alanbagish/C40_upgrades/C40 IMB Upgrade.docx

C40 IMB Upgrade

02/21/2013

1. X-axis guider 1
  a. TMG 5609L-0502 400 steps/rev NEMA 23 stepper 1 each (4 on order)
  b. US Digital E2 relative Encoder E2-400-250-IE-D-D-8 1 each (5 each on hand)
  c. Pepperl+Fuchs NBN4-F29-AO Inductive Proximity NPN N.C. 2 each (1 each on hand, 9 each on order)

Y-axis guider 1

a. TMG 5609L-0502 400 steps/rev NEMA 23 stepper 1 each
b. US Digital E2 relative Encoder E2-400-250-IE-D-D-8 1 each
c. Pepperl+Fuchs NBN4-F29-AO Inductive Proximity N.C. 2 each

Focus 1

  a. Haydon/Kerk Hybrid Linear Actuator Size NEMA 23 Part #: 57J47-05-003ENG 1 each (3 each on hand).
  b. Pepperl+Fuchs NBN4-F29-AO Inductive Proximity NPN N.C. 2 each
  c. Air Cylinder, MRS-021.5-DXP Bimba 1 each
  d. Air Cylinder, MRS-022.5-DXP Bimba 1 each
  e. Air Cylinder, 0071 Bimba 1 each
  f. Position Sensors: Bimba MSKX 5 each
  g. S-H lenslet control
  h. LED control
2. X-axis guider 2
  a. TMG 5609L-0502 400 steps/rev NEMA 23 stepper 1 each
  b. US Digital E2 relative Encoder E2-400-250-IE-D-D-8 1 each
  c. Pepperl+Fuchs NBN4-F29-AO Inductive Proximity NPN N.C. 2 each

Y-axis guider 2

a. TMG 5609L-0502 400 steps/rev NEMA 23 stepper 1 each
b. US Digital E2 relative Encoder E2-400-250-IE-D-D-8 1 each
c. Pepperl+Fuchs NBN4-F29-AO Inductive Proximity NPN N.C. 2 each

Focus 2

a. Haydon/Kerk Hybrid Linear Actuator Size NEMA 23 Part #: 57J47-05-003ENG 1 each
b. Pepperl+Fuchs NBN4-F29-AO Inductive Proximity NPN N.C. 2 each
c. Air Cylinder, MRS-021.5-DXP Bimba 1 each
d. Air Cylinder, MRS-022.5-DXP Bimba 1 each
e. Air Cylinder, 0071 Bimba 1 each
f. Position Sensors: Bimba MSKX 5 each
g. S-H lenslet control
h. LED control
3. Filter Wheel 1

6 position

Detent A microswitch Honeywell 311SM4-T 1 each

Detent B microswitch Honeywell 311SM4-T 1 each

TMG 5609L-0502 0.9 Degree, 400 Steps/Rev Hybrid Stepper, NEMA 23 1 each

Encoder: BEI-HS35F absolute hollow core 4096 or 8192 counts/rev 1 each

4. Filter Wheel 2

6 position

Detent A microswitch Honeywell 311SM4-T 1 each

Detent B microswitch Honeywell 311SM4-T 1 each

TMG 5609L-0502 0.9 Degree, 400 Steps/Rev Hybrid Stepper, NEMA 23 1 each

Encoder: BEI-HS35F absolute hollow core 4096 or 8192 counts/rev. 1 each

5. Galil DMC-4080(ISCNTL)-C012(P422)-I200(SSI,STEP)-I200(SSI,STEP)-D4040-D4040 1 each (on hand)
