alanbagish/C40_upgrades/C40_Tyson_docs/SwopeCommandCommunications.pdf

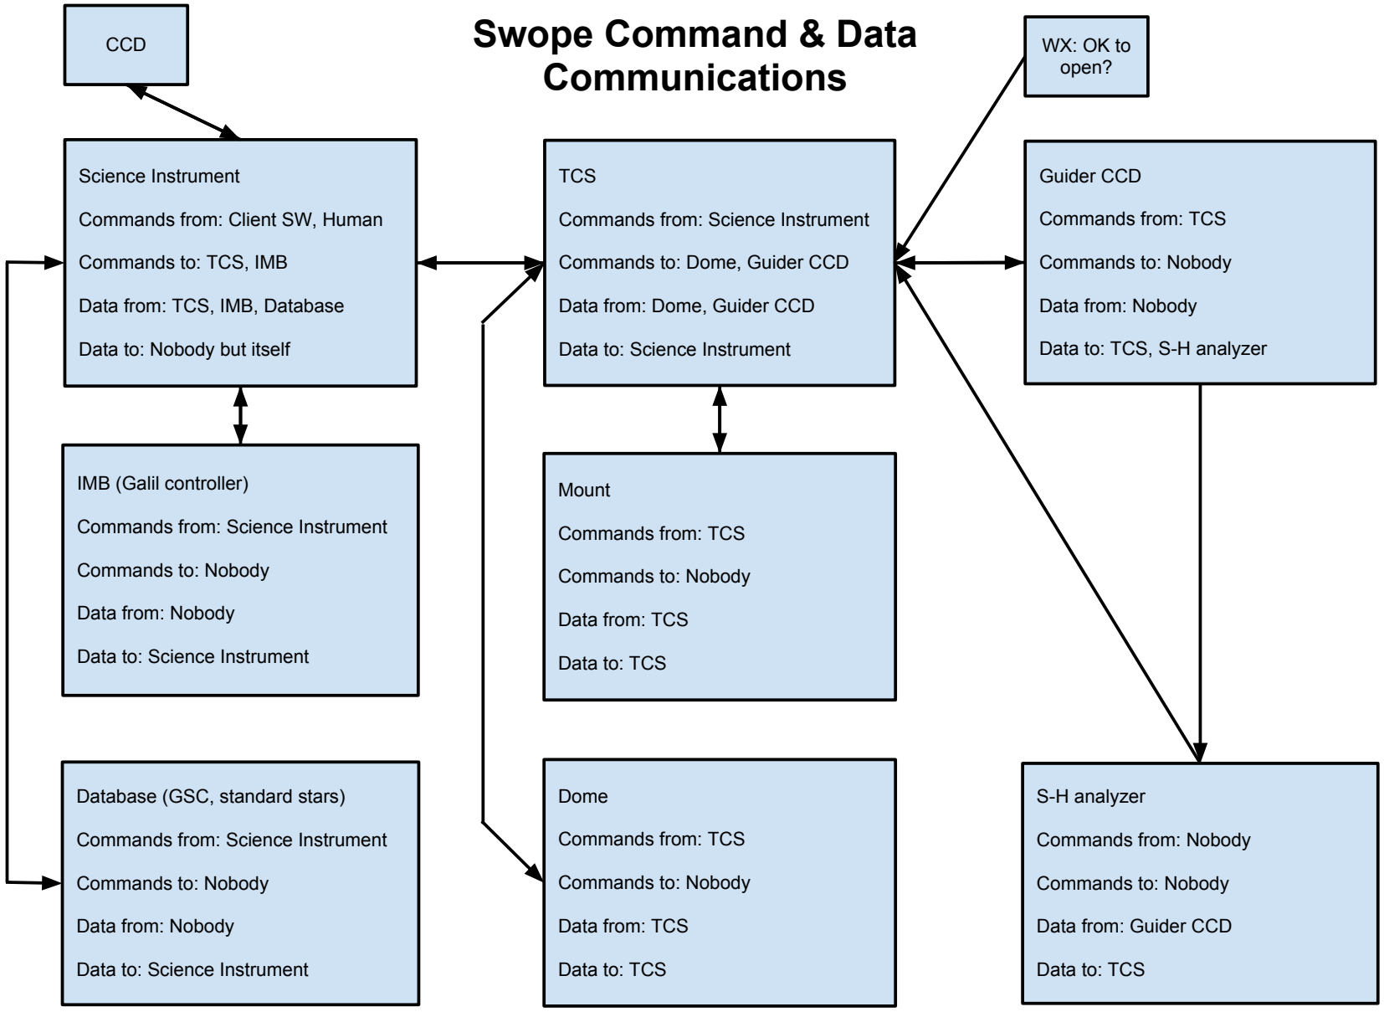
[picture p1: figure]
TCS; Commands from: Science Instrument; Commands to: Dome, Guider CCD; Data from: Dome, Guider CCD; Data to: Science Instrument; IMB (Galil controller); Commands to: Nobody; Data from: Nobody; Guider CCD; Commands from: TCS; Data to: TCS, S-H analyzer; Science Instrument; Commands from: Client SW, Human; Commands to: TCS, IMB; Data from: TCS, IMB, Database; Data to: Nobody but itself; Dome; Data from: TCS; Data to: TCS; S-H analyzer; Commands from: Nobody; Data from: Guider CCD; Swope Command & Data Communications; Database (GSC, standard stars); Mount; WX: OK to open?; CCD
