alanbagish/C40_upgrades/Documents/connectors/3D_CVM_CVM_1735447-8_F.pdf

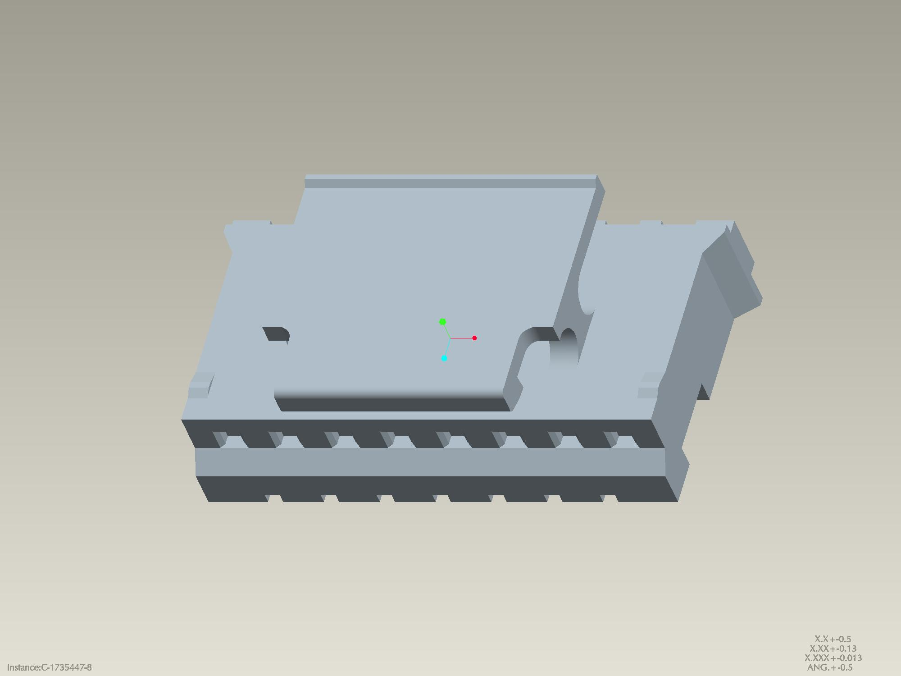
[picture p2: page 1]
