alanbagish/C40_upgrades/Documents/connectors/Molex - 050579404_sd.pdf

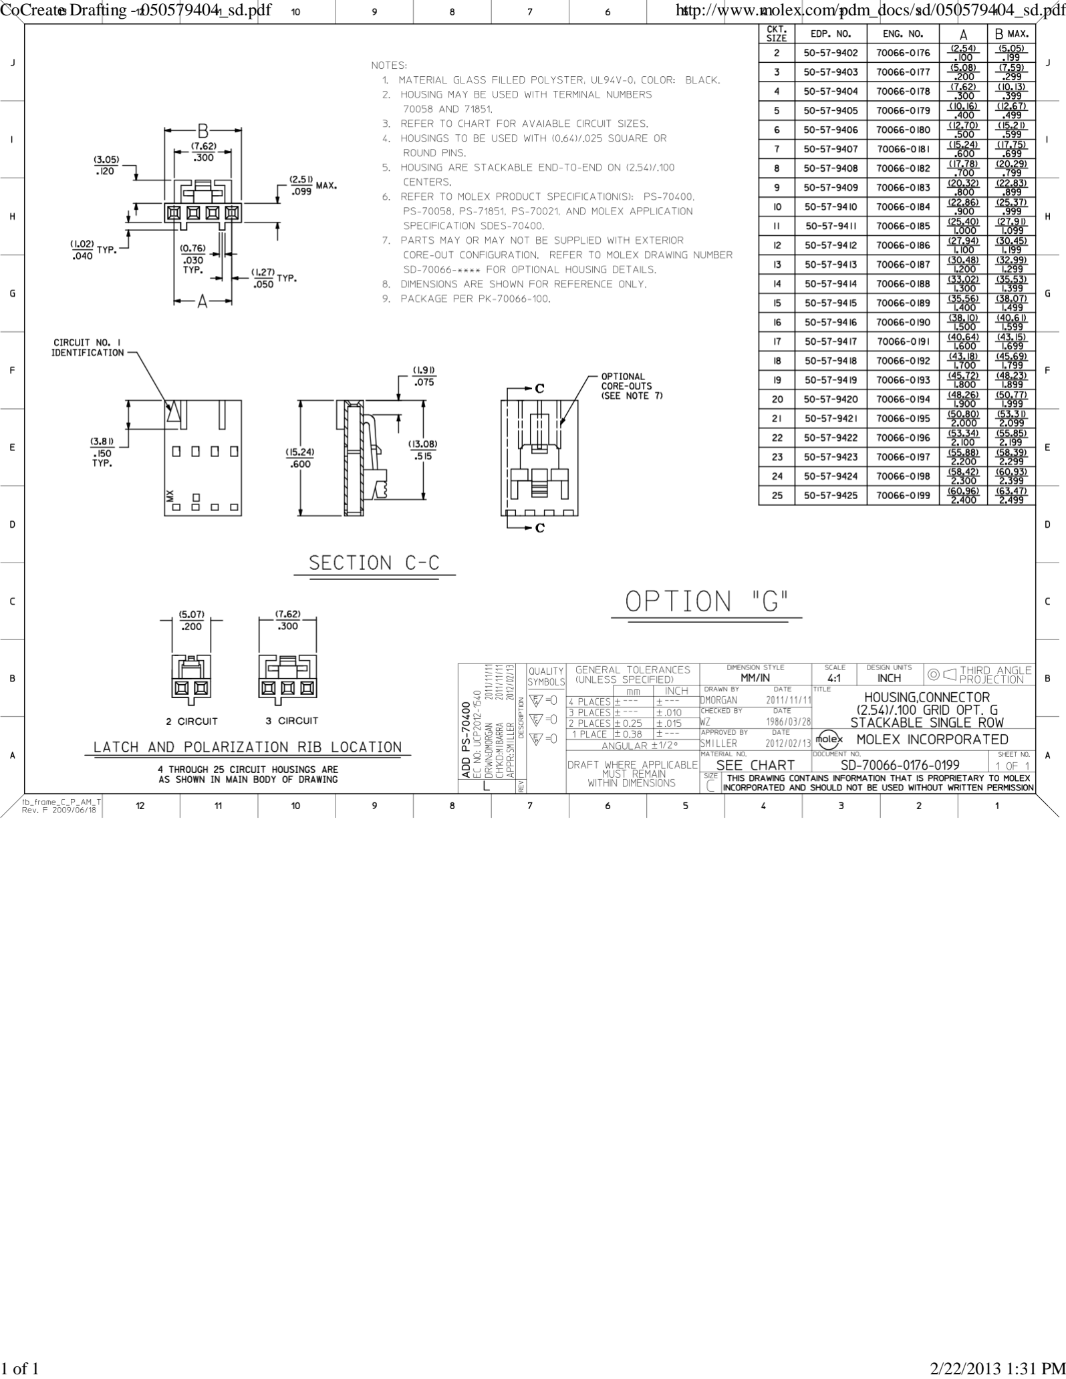
[picture p3: page 1]

CoCreate Drafting - 050579404_sd.pdf | http://www.molex.com/pdm_docs/sd/050579404_sd.pdf
1 of 1 | 2/22/2013 1:31 PM
