alanbagish/C40_upgrades/Documents/connectors/Molex 022552082_sd.pdf

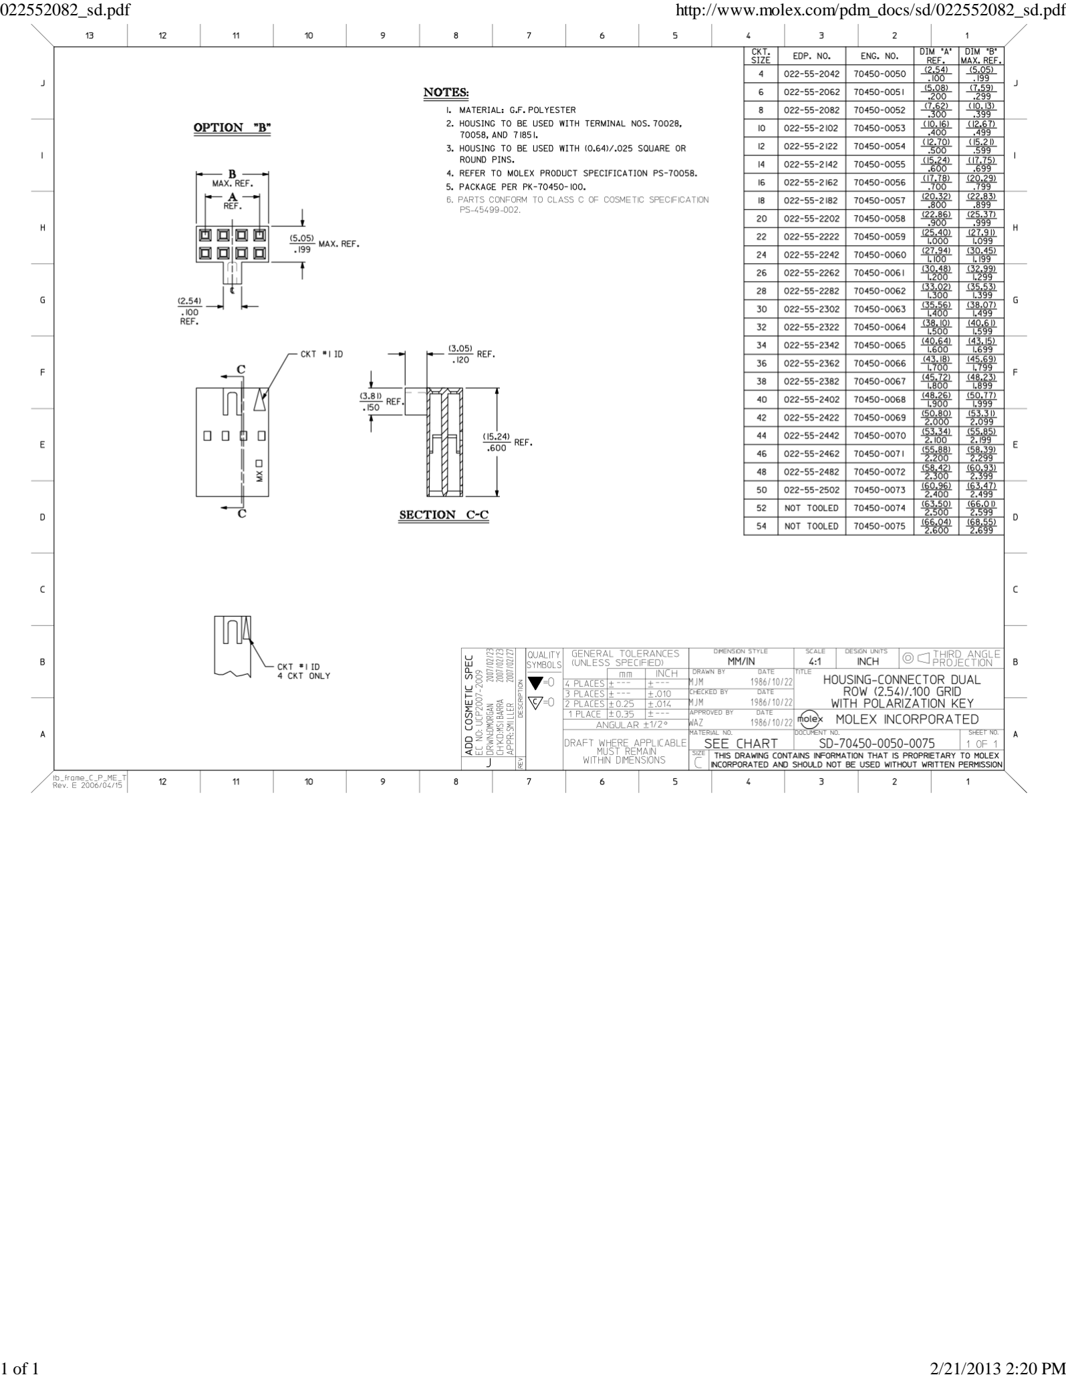
[picture p4: page 1]

022552082_sd.pdf | http://www.molex.com/pdm_docs/sd/022552082_sd.pdf
1 of 1 | 2/21/2013 2:20 PM
