alanbagish/C40_upgrades/Documents/connectors/TE ENG_CD_1735447_F1.pdf

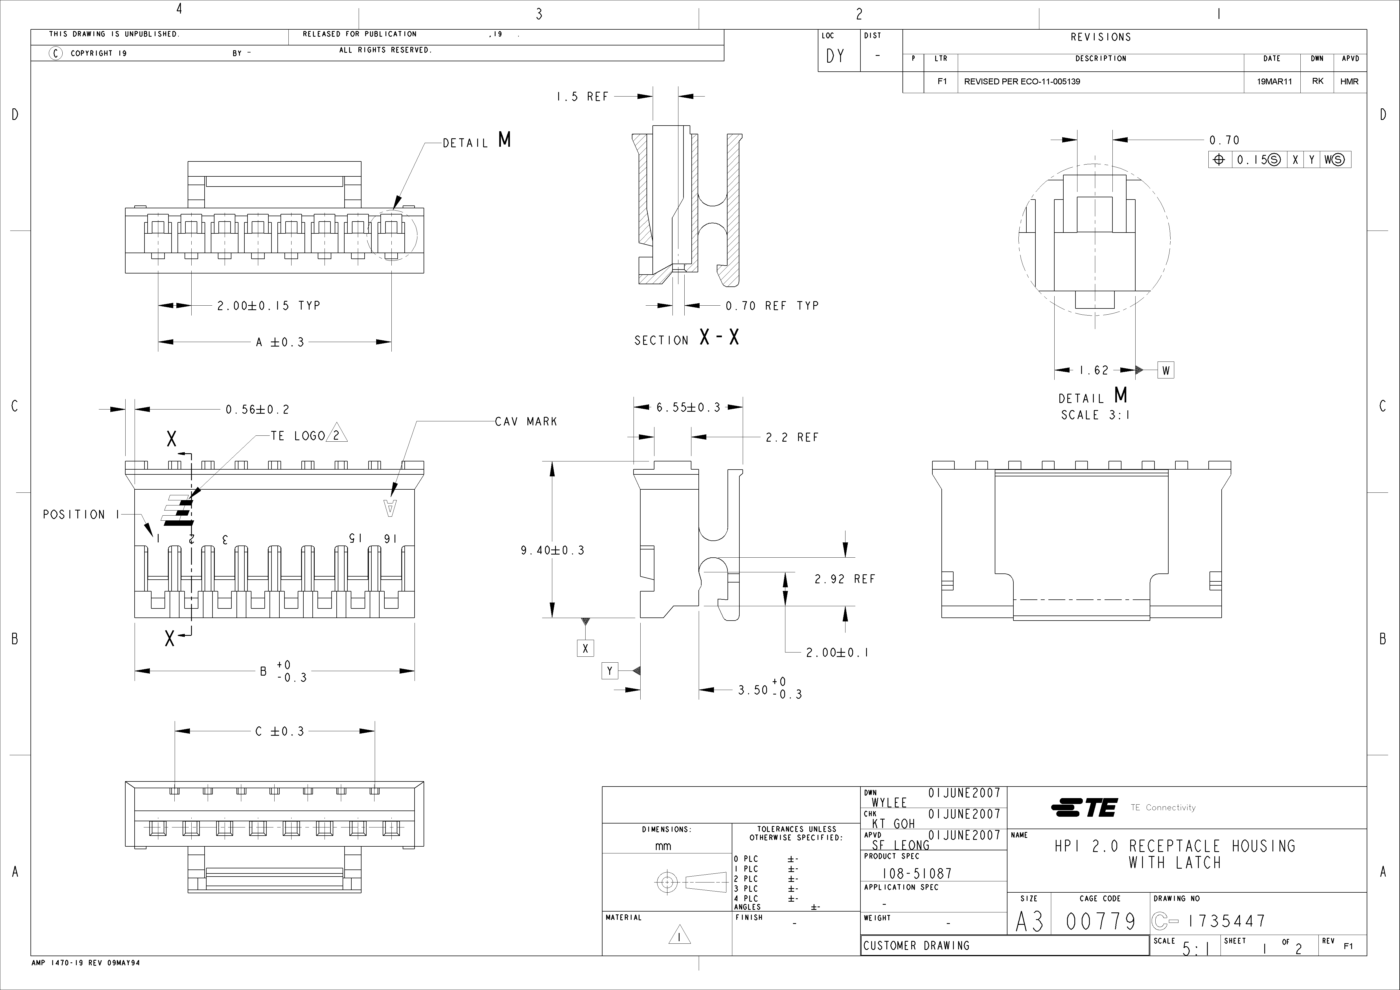
[picture p5: page 1]
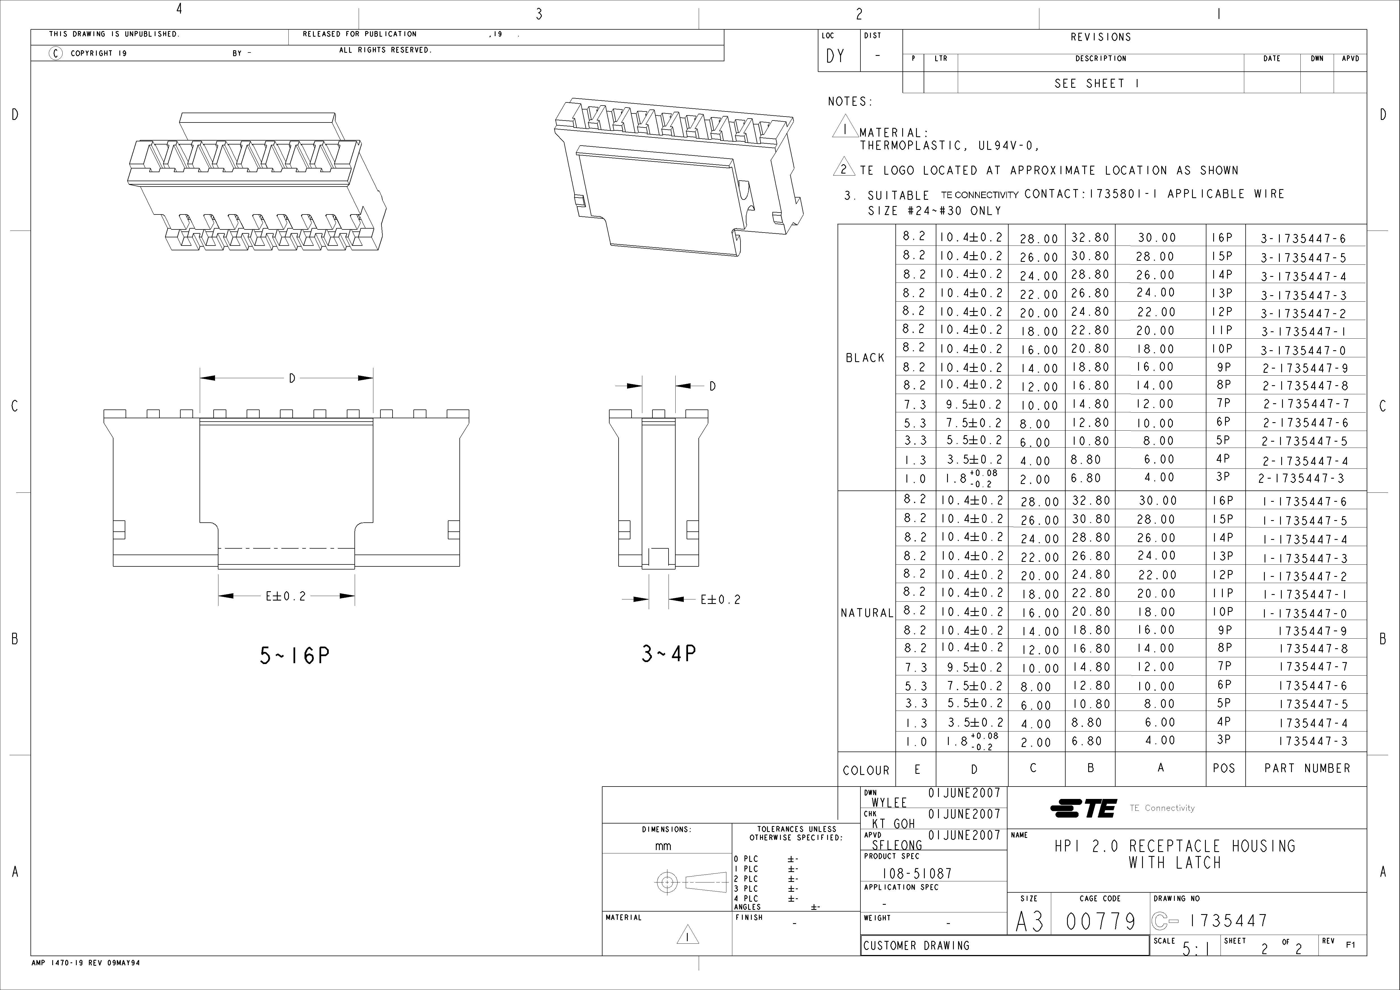
[picture p6: page 2]
