alanbagish/C40_upgrades/Documents/Galil/Galil_3D box Jan 25 3 pm.pdf

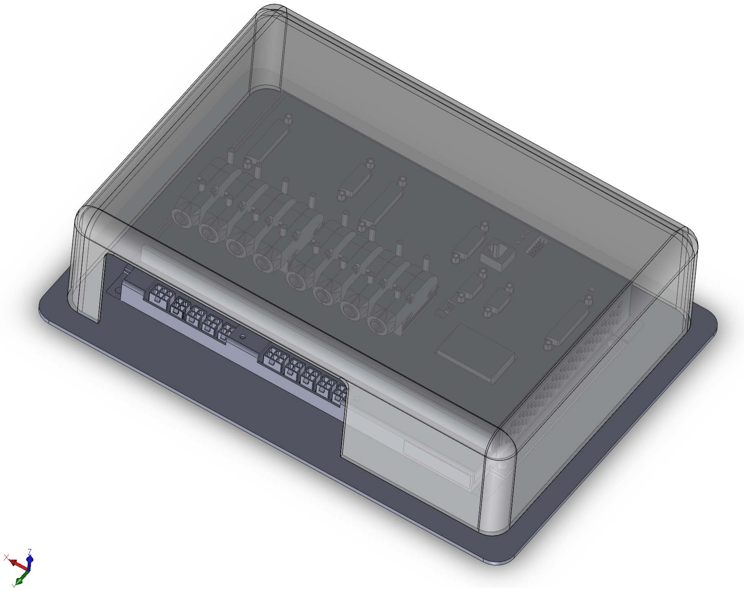
[picture p7: page 1]
