alanbagish/C40_upgrades/Documents/Galil/Galil_box.pdf

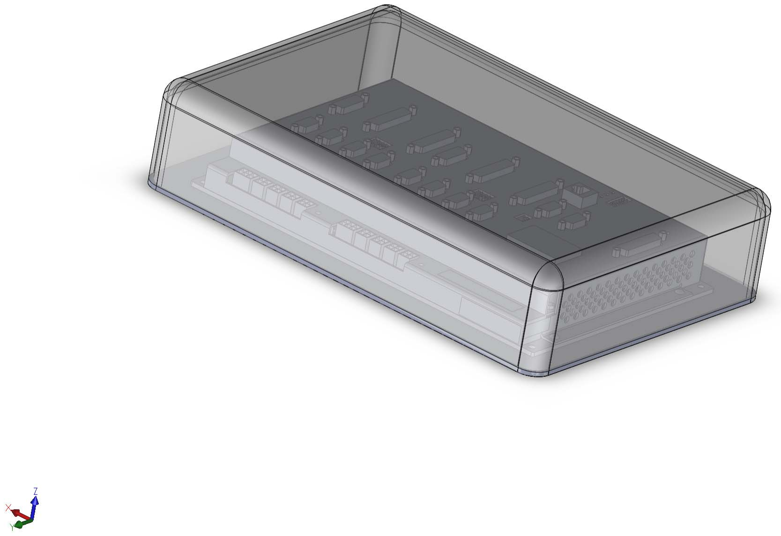
[picture p8: page 1]
