alanbagish/C40_upgrades/Documents/Honeywell microswitch/311sm4-t.pdf

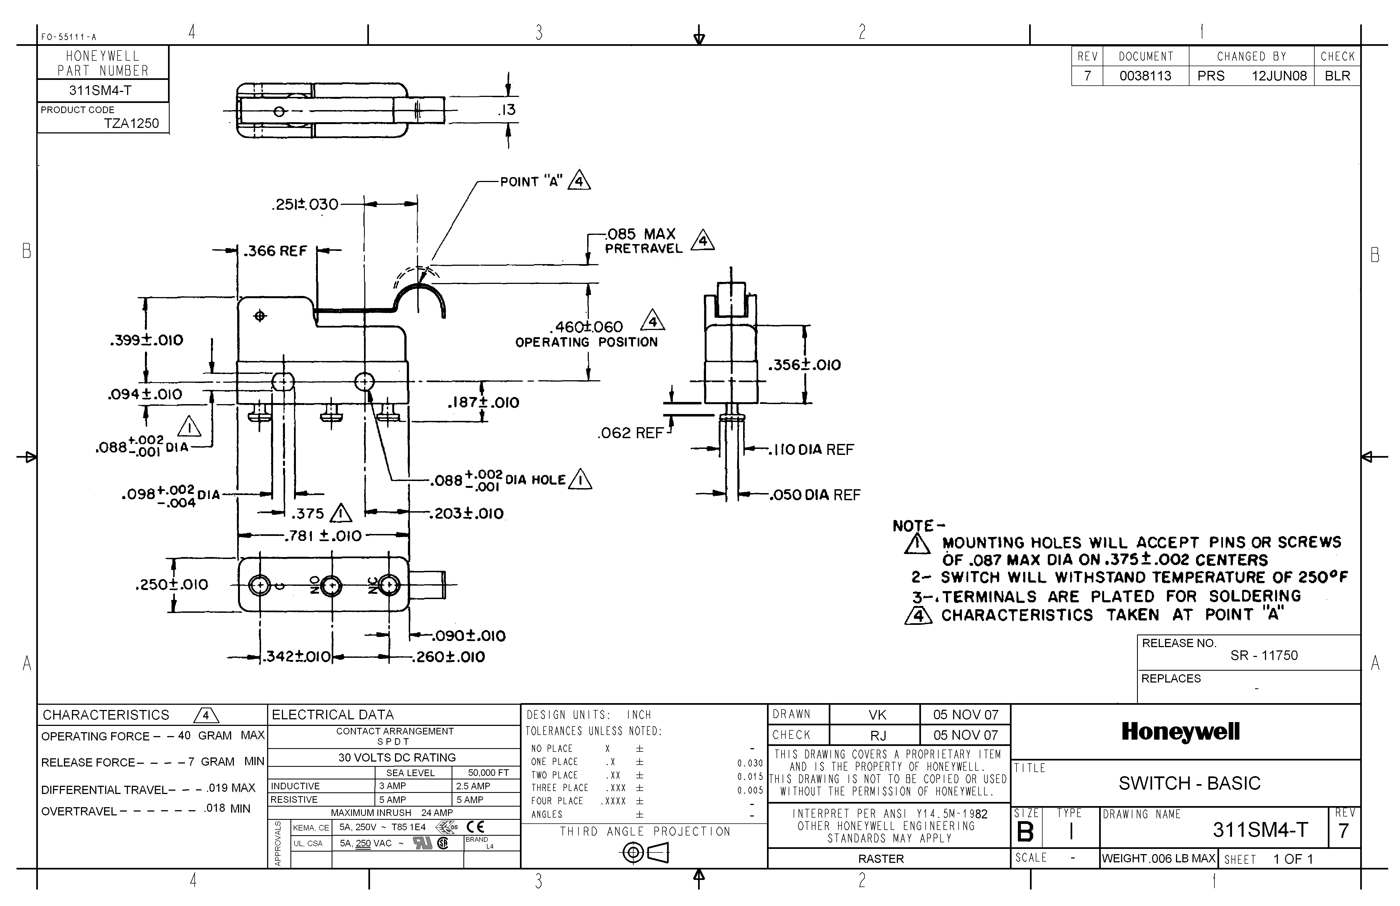
[picture p9: page 1]
