alanbagish/C40_upgrades/Documents/US Digital 10 pin.JPG

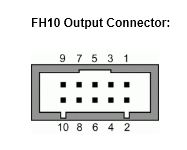
Documents/US Digital 10 pin.JPG
