alanbagish/C40_upgrades/Documents/Power Supplies/C40 Power Supply selection.xlsx

 | Manufacturer | Distributor | Distributor # | Type | Efficiancy | Amps | Model Number | In Stock | Price | Length | Width | Height
5V @ 3A | Omron Electronics Inc-IA Div (http://digikey.com/Suppliers/us/Omron-Industrial-Automation.page?lang=en) |  | Z1153-ND | Open | 83 | 3 | S8E1-01505D | 0 |  | 78mm | 2.72" | 34mm
 | TDK-Lambda Americas Inc (http://digikey.com/Suppliers/us/TDK-Lambda-Americas.page?lang=en) |  | 285-1317-ND | Closed | 79 | 3 | HWS15-5/A | 69 | $48.68 | 80 | 31.5 | 82
 | TDK LAMBDA |  | 80K5877 (http://www.newark.com/tdk-lambda/hk15a-5-a/ac-dc-conv-enclosed-1-o-p-15w-3a/dp/80K5877) | Closed |  | 3 | HK15A-5/A (http://www.newark.com/tdk-lambda/hk15a-5-a/ac-dc-conv-enclosed-1-o-p-15w-3a/dp/80K5877) | 45 | $34.65 | 1.08 | 2.83 | 3.31
 | TDK LAMBDA |  | 09K9416 (http://www.newark.com/tdk-lambda/hws15-5-a/ac-dc-conv-enclosed-1-o-p-15w-3a/dp/09K9416) | Closed | 68 | 3 | HWS15-5/A (http://www.newark.com/tdk-lambda/hws15-5-a/ac-dc-conv-enclosed-1-o-p-15w-3a/dp/09K9416) | 152 | $42.00 | 3.15 | 1.04 | 3.23
 | Phoenix Contact | Allied | 70001027 | DIN | 73 | 3 | 2938714 | 35 | $118.90 | 3.9" | 0.89" | 4.2" | 4.5-5.5V adjustable | current consumption 0.4A
24V @ 2.5A | Condor |  | 271-2313-ND (http://www.digikey.com/product-detail/en/GLC65-24G/271-2313-ND/1036566) | Open | 94 | 2.7 | GLC65-24G (http://www.digikey.com/product-detail/en/GLC65-24G/271-2313-ND/1036566) | 53 | $98.08 | 5" | 3" | 1.06"
 | TRIAD MAGNETICS (http://www.newark.com/triad-magnetics) |  | 237-1302-ND | Closed | 81 | 2.5 | AWSP60-24 | 38 | $24.00 | 160 | 38 | 98
 | SIEMENS | Newark | 03M4788 | DIN | 87 | 2.5 | 6EP1332-1SH43 | 20 | $136.18 | 2.17 | 2.84 | 3.54 | 22.2-26.4 adjustable
 | Phoenix Contact | Allied |  | DIN | 88 | 3.5 | 2866747 | 72 | $188.00 | 4.92" | 1.26" | 5.1" | 18-29.5 adjustable | current consumption 3A
24V @ 10A | TDK-Lambda Americas Inc (http://digikey.com/Suppliers/us/TDK-Lambda-Americas.page?lang=en) |  | 285-2178-ND | Open | 94 | 12.5 | U7Y0269 | 20 | $471.34 | 7" | 3.94" | 1.56"
 | TRACOPOWER |  | 51R7821 | Closed | 91 | 10 | TXH 240-124 | 42 (UK) | $147.07 | 5.39 | 3.23 | 1.5
 | TDK LAMBDA |  | 48T0588 | Closed | 92 | 10.5 | GWS250-24 | 12 | $161.46 | 198 | 105 | 41mm
 | EMERSON NETWORK POWER (http://www.newark.com/emerson-network-power) |  | 92B3730 | Closed | 75 | 10.4 | LPS255-C | 22 | $304.06 | 10.32 | 5 | 2 | 24-48VDC ajustable | with sense lines
 | Sola |  | 80K9315 | DIN |  | 10 | SDN10-24-100P | 77 | $379.63 | 4.88 | 3.23 | 4.55
 | SIEMENS | Newark | 98K9923 | DIN | 89 | 10 | 6EP1334-2BA00 | 8 (UK) | $334.63 | 135 | 100 | 125
 | Phoenix Contact | Allied | 2866323 (http://www.alliedelec.com/search/productdetail.aspx?SKU=70000961) | DIN | 89 | 10 | 70000961 | 34 | $228.05 | 5.12" | 2.36" | 6" | 22.5-29.5 adjustable | current consumption 3A
 |  | Allied | 70191429 | 2.0 THIN CONNECTOR KIT LOCKING PLUG & RECEPT (http://www.alliedelec.com/search/productdetail.aspx?SKU=70191429) |  |  |  | 0
http://www.generalcable.com/NR/rdonlyres/49ED0582-0454-4A97-99E4-874A290F769C/0/Carolprene105CWeldingCableSpecSheet.pdf
