alanbagish/C40_upgrades/Documents/connectors/encoder housing/Assem1.SLDASM

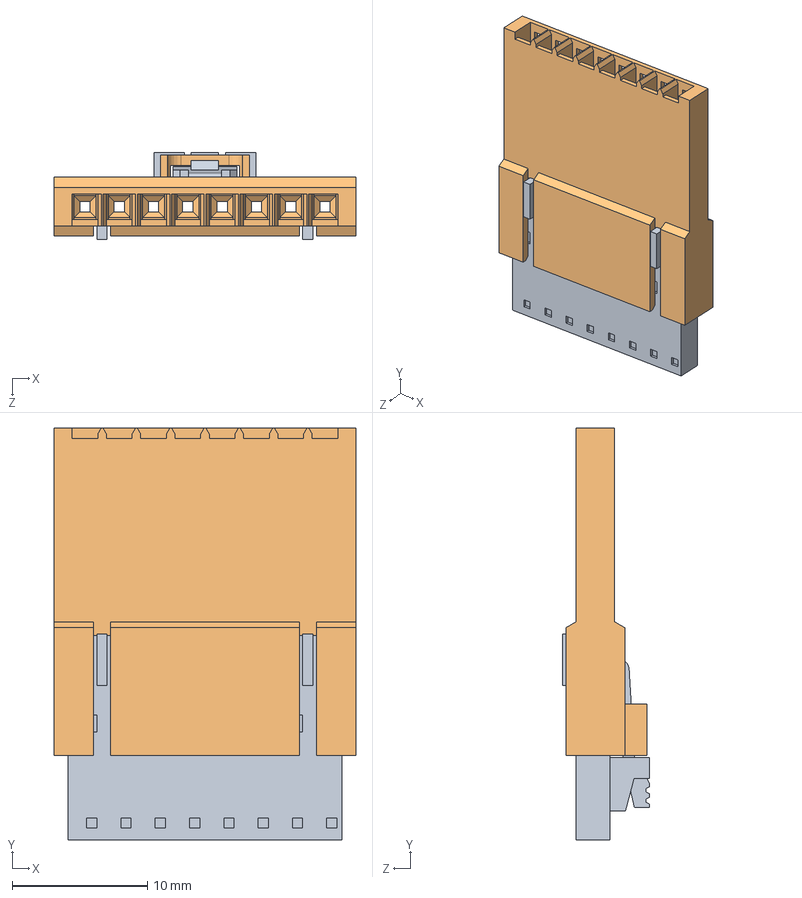
[picture p11: CAD file, 2013-02-22]
Documents/connectors/encoder housing/Assem1.SLDASM
22.4 x 30.5 x 6.45 mm
701070007 housing
