alanbagish/C40_upgrades/solids/HD15M-RA connector assembly.SLDASM

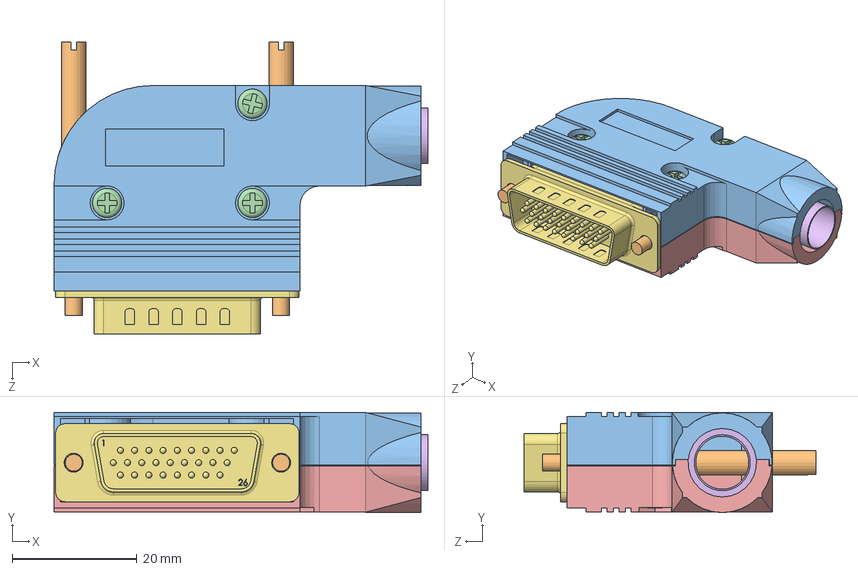
[picture p13: CAD file, 2013-01-28]
solids/HD15M-RA connector assembly.SLDASM
60.1 x 16.1 x 46.9 mm
SDRA9AG-MA4_DEFAULT x 3
SDRA9AG-MA5 x 2
SDRA15AG-MA1
SDRA9AG-MA3_4-40 x .437 PAN HEAD SCREW SS x 3
SDRA15AG-MA2
SDC15G-MA1_SDC15G-1
SDH26P HD d-sub
