alanbagish/C40_upgrades/solids/SDRA15AG d-sub 15 hood.SLDASM

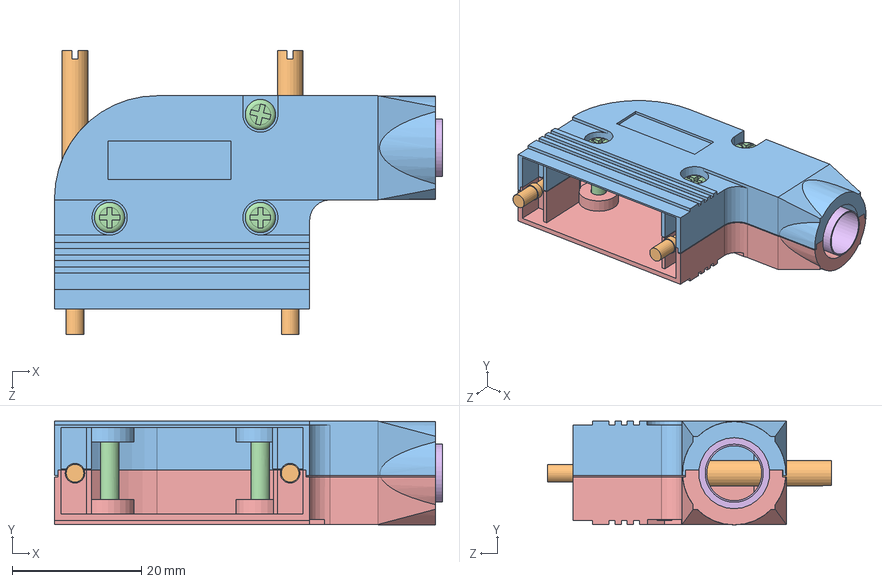
[picture p14: CAD file, 2013-01-28]
solids/SDRA15AG d-sub 15 hood.SLDASM
60.1 x 16.1 x 43.9 mm
SDRA9AG-MA4_DEFAULT x 3
SDRA9AG-MA5 x 2
SDRA15AG-MA1
SDRA9AG-MA3_4-40 x .437 PAN HEAD SCREW SS x 3
SDRA15AG-MA2
SDC15G-MA1_SDC15G-1
