alanbagish/C40_upgrades/solids/DMC4080_A_model-42200.sldasm

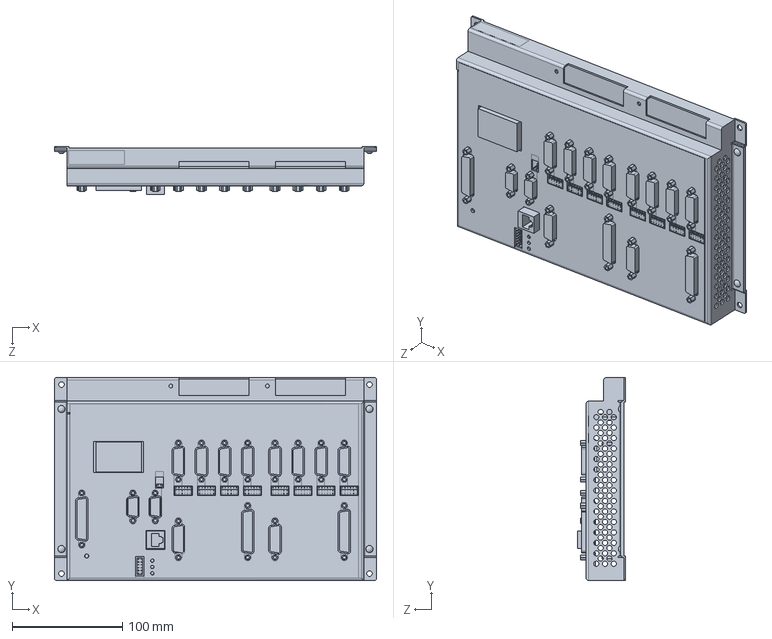
[picture p16: CAD file, 2013-01-28]
solids/DMC4080_A_model-42200.sldasm
292.1 x 184.3 x 43.9 mm
