alanbagish/C40_upgrades/solids/Galil_box Jan 25 3 pm.SLDASM

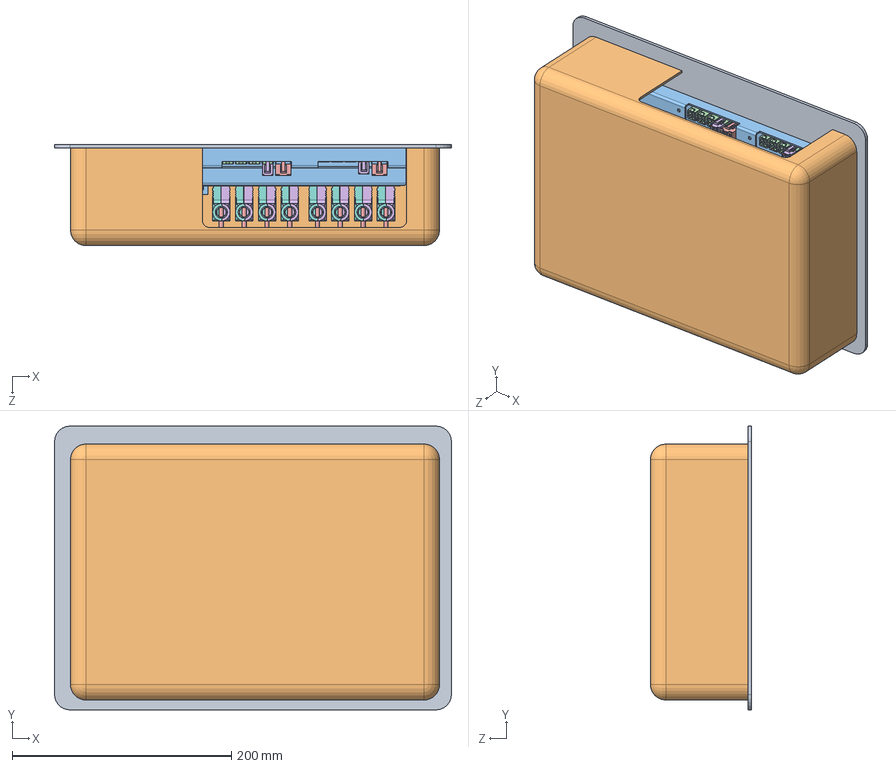
[picture p17: CAD file, 2013-01-28]
solids/Galil_box Jan 25 3 pm.SLDASM
361.9 x 258.8 x 92.4 mm
blister box
Zero Z147_212A blister box
DMC4080_A_model-42200
SDRA9AG-MA4_DEFAULT x 24
SDRA9AG-MA5 x 16
SDRA15AG-MA1 x 8
SDRA9AG-MA3_4-40 x .437 PAN HEAD SCREW SS x 24
SDRA15AG-MA2 x 8
SDC15G-MA1_SDC15G-1 x 8
SDH26P HD d-sub x 8
039310060 Molex 6 power header x 2
039310040 Molex 4 pin header x 9
050361672 Molex 6 plug x 2
039012045 Molex 4 pin plug x 2
