alanbagish/C40_upgrades/solids/Zero Z147_212A blister box.SLDPRT

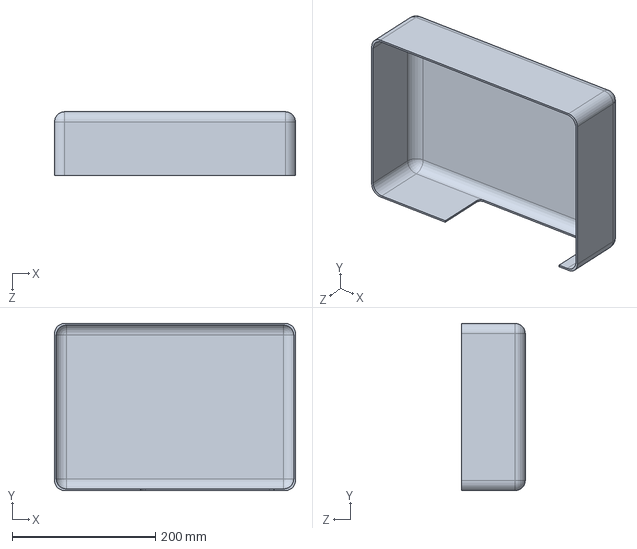
[picture p18: CAD file, 2013-01-28]
solids/Zero Z147_212A blister box.SLDPRT
336.5 x 233.4 x 88.9 mm
