alanbagish/C40_upgrades/solids/DMC4080_01_model-42000 from step model.SLDPRT

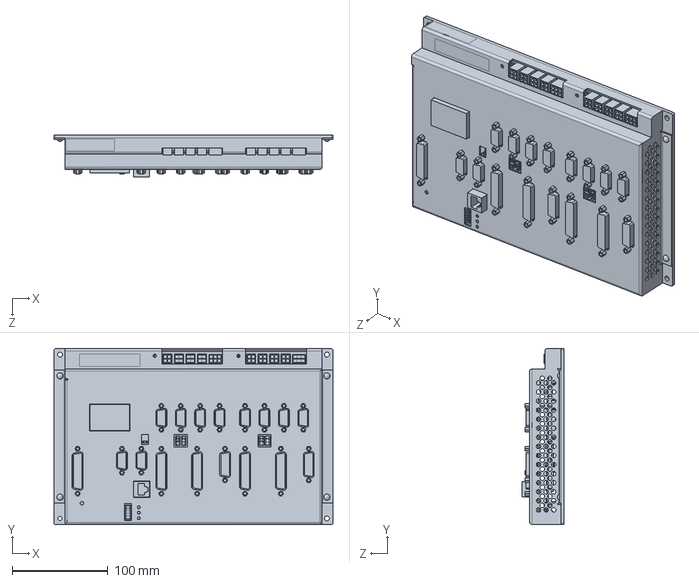
[picture p19: CAD file, 2013-01-28]
solids/DMC4080_01_model-42000 from step model.SLDPRT
292.1 x 184.4 x 43.9 mm
