alanbagish/C40_upgrades/solids/box lid.SLDPRT

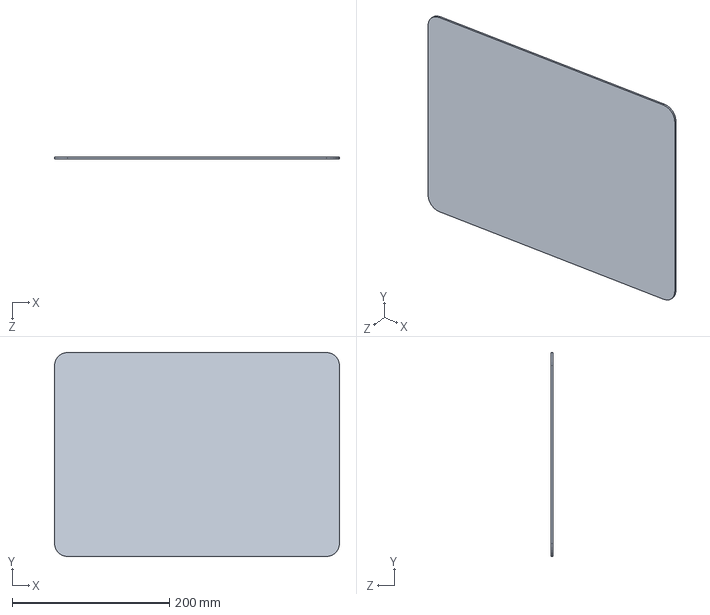
[picture p20: CAD file, 2013-01-28]
solids/box lid.SLDPRT
361.9 x 259.1 x 2.29 mm
