alanbagish/C40_upgrades/solids/SDH26P HD d-sub.SLDPRT

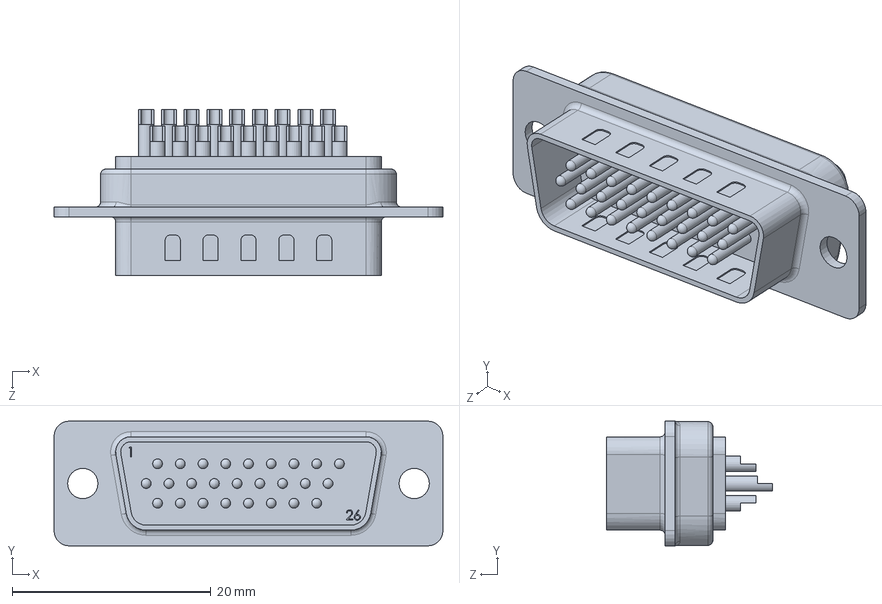
[picture p21: CAD file, 2013-01-28]
solids/SDH26P HD d-sub.SLDPRT
39.1 x 12.5 x 16.7 mm
