alanbagish/C40_upgrades/solids/blister box2.sldprt

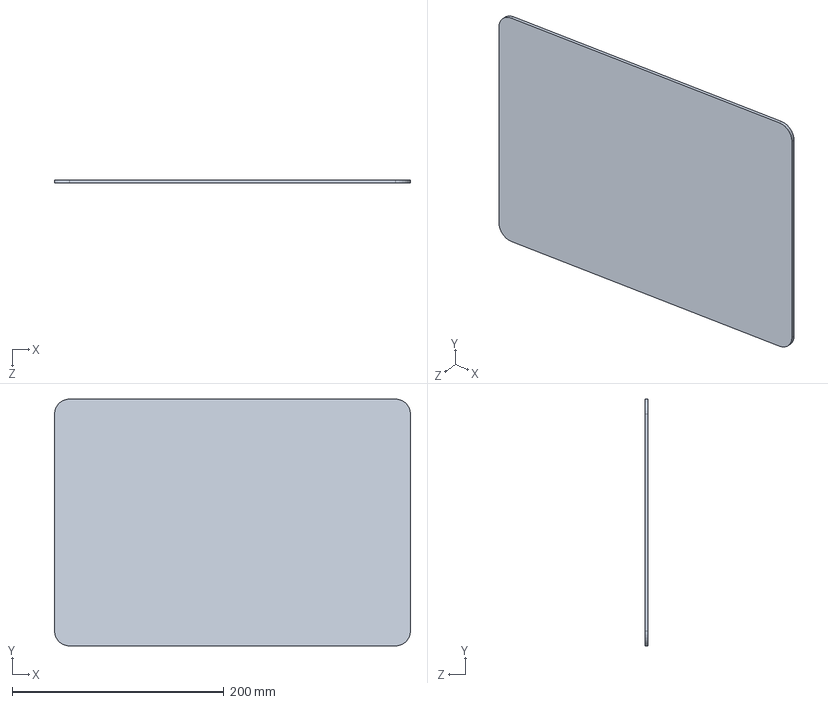
[picture p22: CAD file, 2013-01-28]
solids/blister box2.sldprt
336.5 x 233.4 x 3.17 mm
