alanbagish/C40_upgrades/solids/DMC4080_01_model-42000.SLDPRT

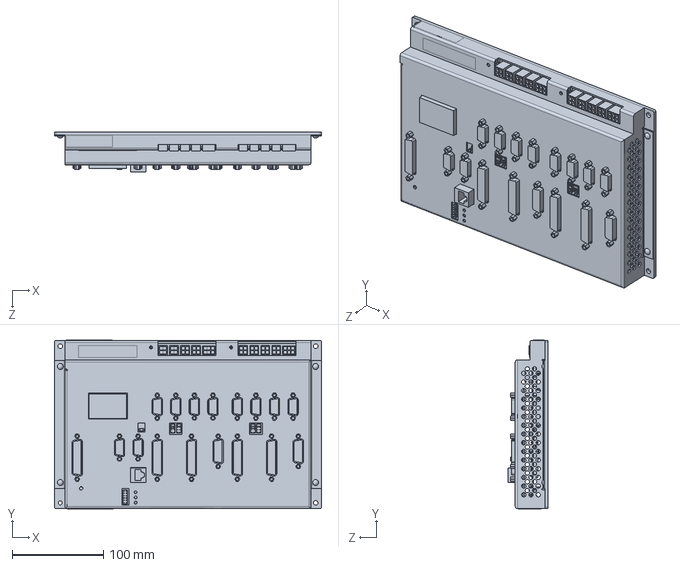
[picture p23: CAD file, 2013-01-28]
solids/DMC4080_01_model-42000.SLDPRT
292.1 x 184.4 x 43.9 mm
