alanbagish/C40_upgrades/solids/PC4-H10_SolidWorks2.SLDPRT

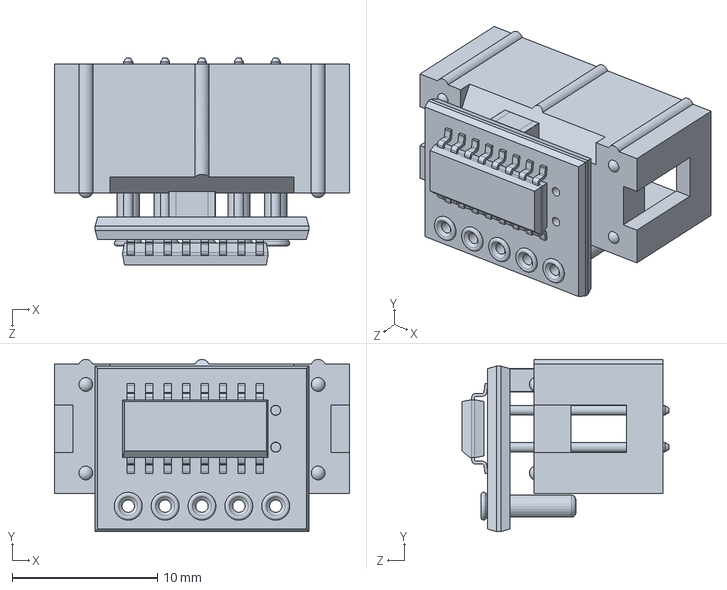
[picture p24: CAD file, 2013-01-28]
solids/PC4-H10_SolidWorks2.SLDPRT
20.3 x 11.9 x 14.2 mm
