alanbagish/C40_upgrades/(list of files, cad)

Other CAD files:
solids/DMC4080_A_model-42200-1.sldasm
solids/1.sldprt
solids/2.sldprt
solids/3.sldprt
solids/4.sldprt
solids/SDRA15AG-MA1.sldprt
solids/blister box.sldprt
solids/SDC15G-MA1_SDC15G-1.sldprt
solids/SDRA9AG-MA5.sldprt
solids/SDRA15AG-MA2.sldprt
solids/SDRA9AG-MA4_DEFAULT.sldprt
Documents/connectors/encoder housing/701070007 housing.SLDPRT
Documents/connectors/encoder housing/701070007.stp
Documents/connectors/encoder plug/050579408.SLDPRT
Documents/connectors/encoder plug/050579408.stp
solids - Copy/Box with cover.SLDASM
solids - Copy/DMC4080_01_model-42000.SLDPRT
solids - Copy/DMC4080_A_model-42200-1.sldasm
solids - Copy/DMC4080_A_model-42200-1.sldprt
solids - Copy/DMC4080_A_model-42200-2.sldasm
solids - Copy/DMC4080_A_model-42200-2.sldprt
solids - Copy/DMC4080_A_model-42200-3.sldasm
solids - Copy/DMC4080_A_model-42200-3.sldprt
solids - Copy/DMC4080_A_model-42200-4.sldasm
solids - Copy/DMC4080_A_model-42200-4.sldprt
solids - Copy/DMC4080_A_model-42200-5.sldasm
solids - Copy/DMC4080_A_model-42200.sldasm
solids - Copy/DMC4080_A_model-42200.sldprt
solids - Copy/Galil_box 1 24 pm.SLDASM
solids - Copy/Galil_box.SLDASM
solids - Copy/LOGO_SM2-4.sldprt
solids - Copy/SDC15G-MA1_SDC15G-1.sldprt
solids - Copy/SDH26P.step
solids - Copy/SDRA15AG-MA1.sldprt
solids - Copy/SDRA15AG-MA2.sldprt
solids - Copy/SDRA15AG.step
solids - Copy/SDRA9AG-MA3_4-40 x .437 PAN HEAD SCREW SS.sldprt
solids - Copy/SDRA9AG-MA4_DEFAULT.sldprt
solids - Copy/SDRA9AG-MA5.sldprt
solids - Copy/Zero Z147_212A blister box.SLDPRT
solids - Copy/blister box.sldprt
solids - Copy/box.SLDPRT
solids/01234011 released Rose box.SLDASM
solids/039012045 Molex 4 pin plug.SLDPRT
solids/039012045 Molex 4 pin plug.stp
solids/039310040 Molex 4 pin header.SLDPRT
solids/039310040 Molex 4 pin header.stp
solids/039310060 Molex 6 power header.SLDPRT
solids/039310060 Molex 6 power header.stp
solids/050361672 Molex 6 plug.SLDPRT
solids/050361672 Molex 6 plug.stp
solids/DMC4080_A_model-42200-1.sldprt
solids/DMC4080_A_model-42200.sldprt
solids/Galil_box Jan 25 3 pm.SLDDRW
solids/Rose alum box 012340110.SLDDRW
solids/Rose alum box 013140110.SLDDRW
solids/SDRA9AG-MA3_4-40 x .437 PAN HEAD SCREW SS.sldprt
