alanbagish/C40_upgrades/C40_Tyson_docs/Small Guider Assembly Drawings.pdf

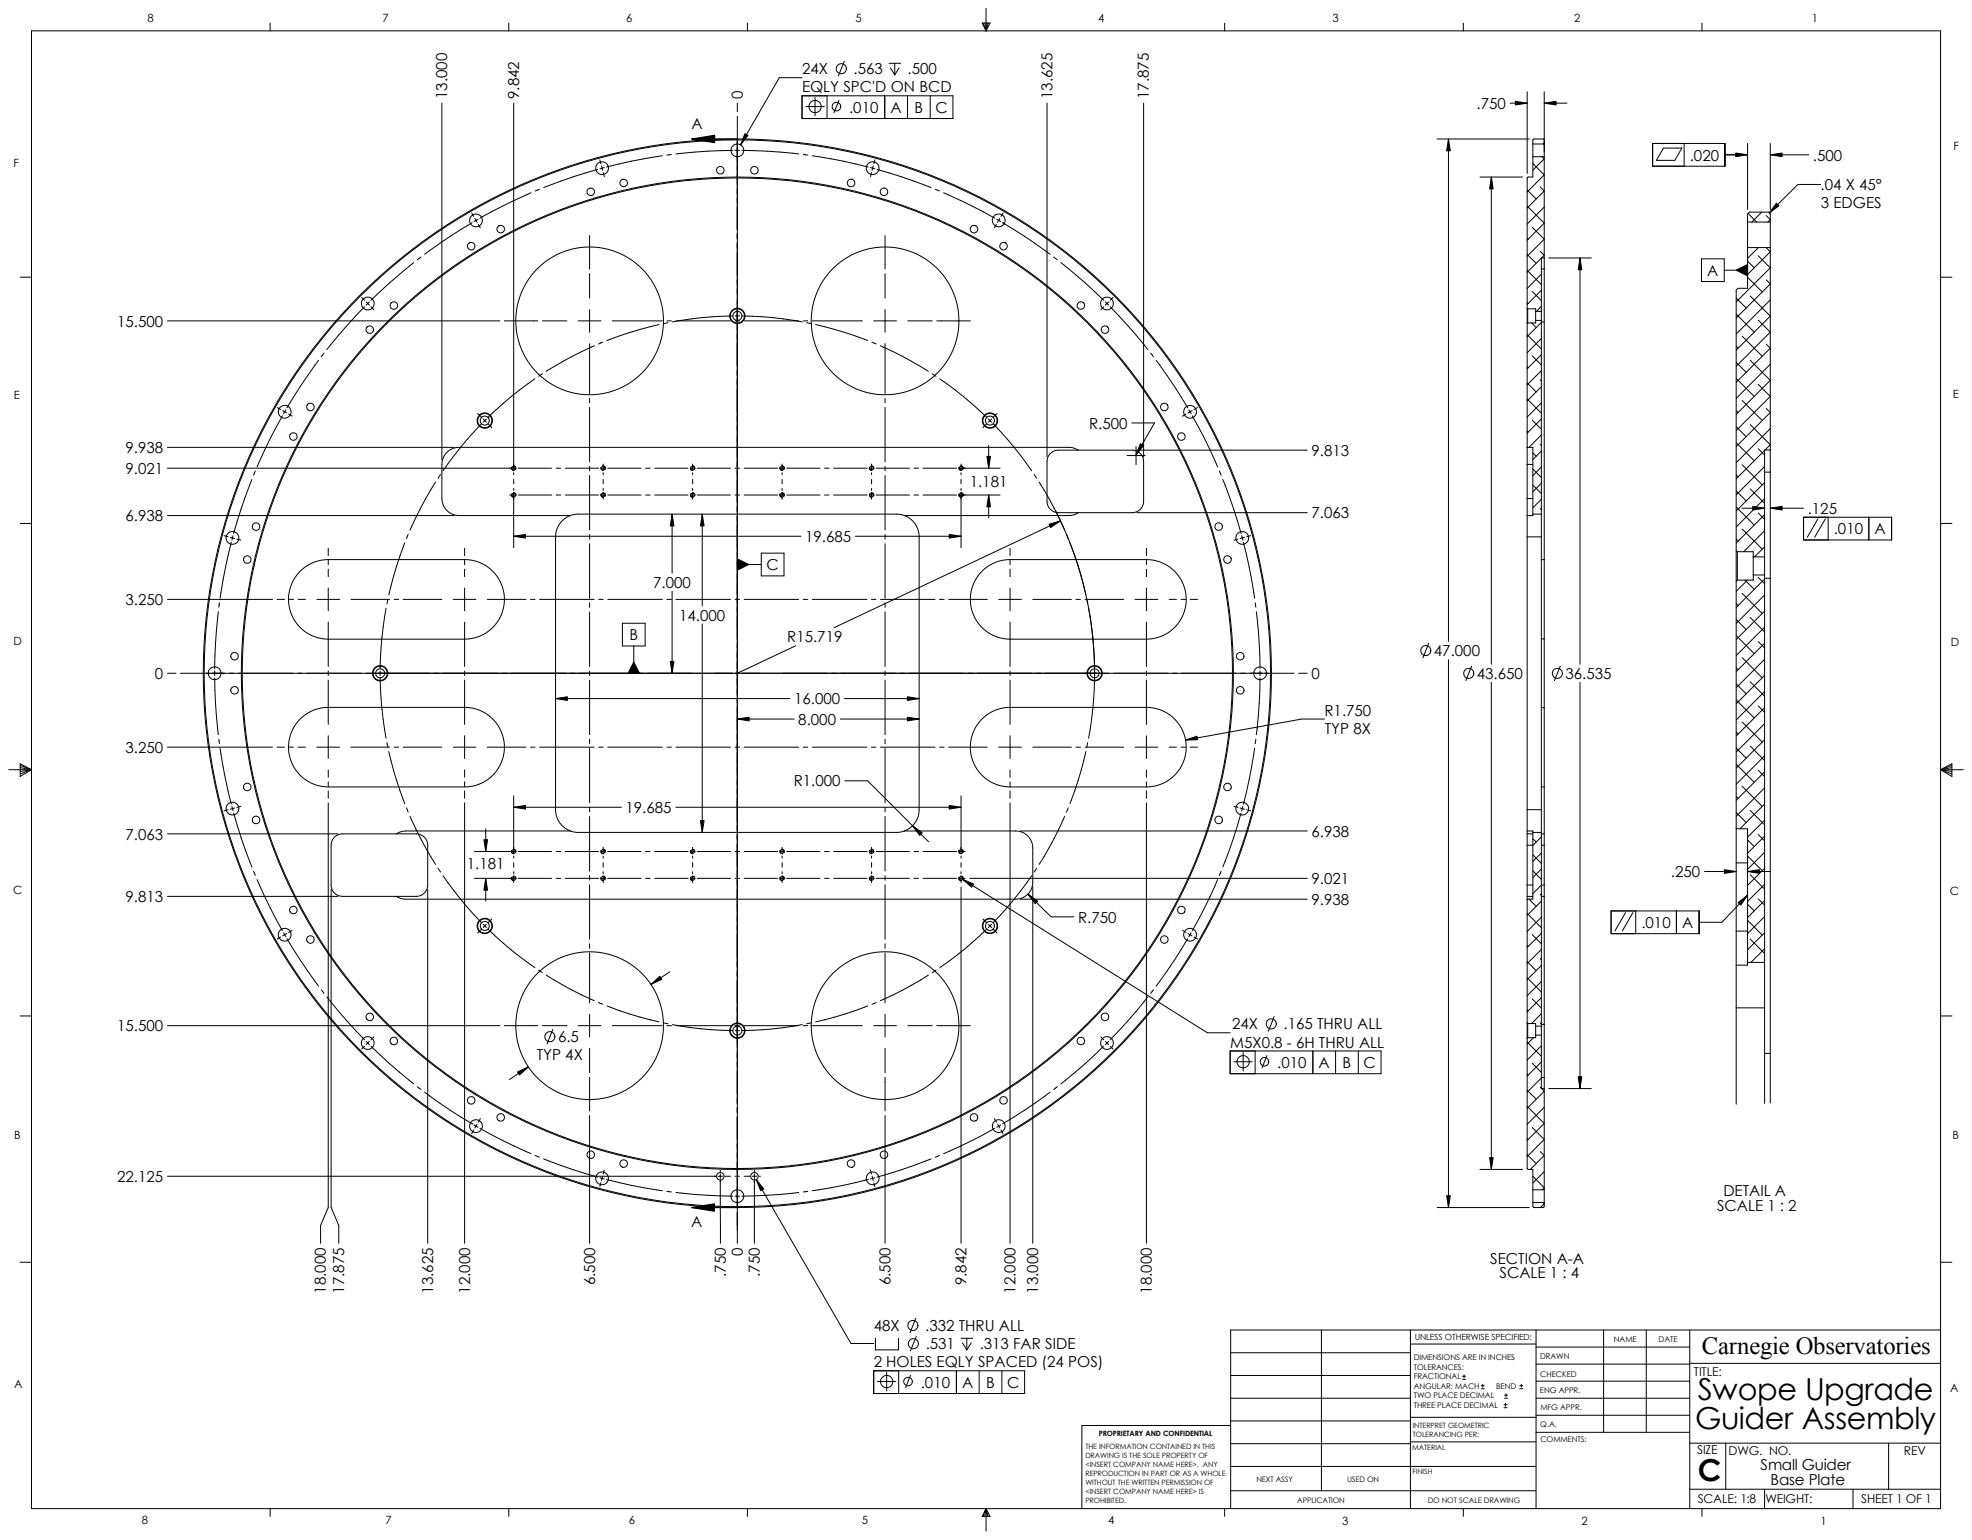
[picture p39: page 1]
TYP 8X; TYP 4X; .313 FAR SIDE; .332 THRU ALL; .165 THRU ALL; M5X0.8 - 6H THRU ALL; BEND; COMMENTS:; SECTION A-A SCALE 1 : 4; SCALE 1 : 2; DETAIL A; 3 EDGES

EQLY SPC'D ON BCD

UNLESS OTHERWISE SPECIFIED: | | NAME | DATE | Carnegie Observatories

2 HOLES EQLY SPACED (24 POS)

DIMENSIONS ARE IN INCHES
TOLERANCES:
FRACTIONAL
ANGULAR: MACH
TWO PLACE DECIMAL
THREE PLACE DECIMAL

DRAWN
CHECKED | | | TITLE: Swope Upgrade Guider Assembly

ENG APPR.

MFG APPR.

INTERPRET GEOMETRIC TOLERANCING PER: | Q.A.
MATERIAL | | SIZE C | DWG. NO. Small Guider Base Plate | REV

PROPRIETARY AND CONFIDENTIAL
THE INFORMATION CONTAINED IN THIS
DRAWING IS THE SOLE PROPERTY OF
<INSERT COMPANY NAME HERE>. ANY
REPRODUCTION IN PART OR AS A WHOLE
WITHOUT THE WRITTEN PERMISSION OF
<INSERT COMPANY NAME HERE> IS
PROHIBITED.

NEXT ASSY | USED ON | FINISH

APPLICATION | DO NOT SCALE DRAWING | | SCALE: 1:8 | WEIGHT: | SHEET 1 OF 1

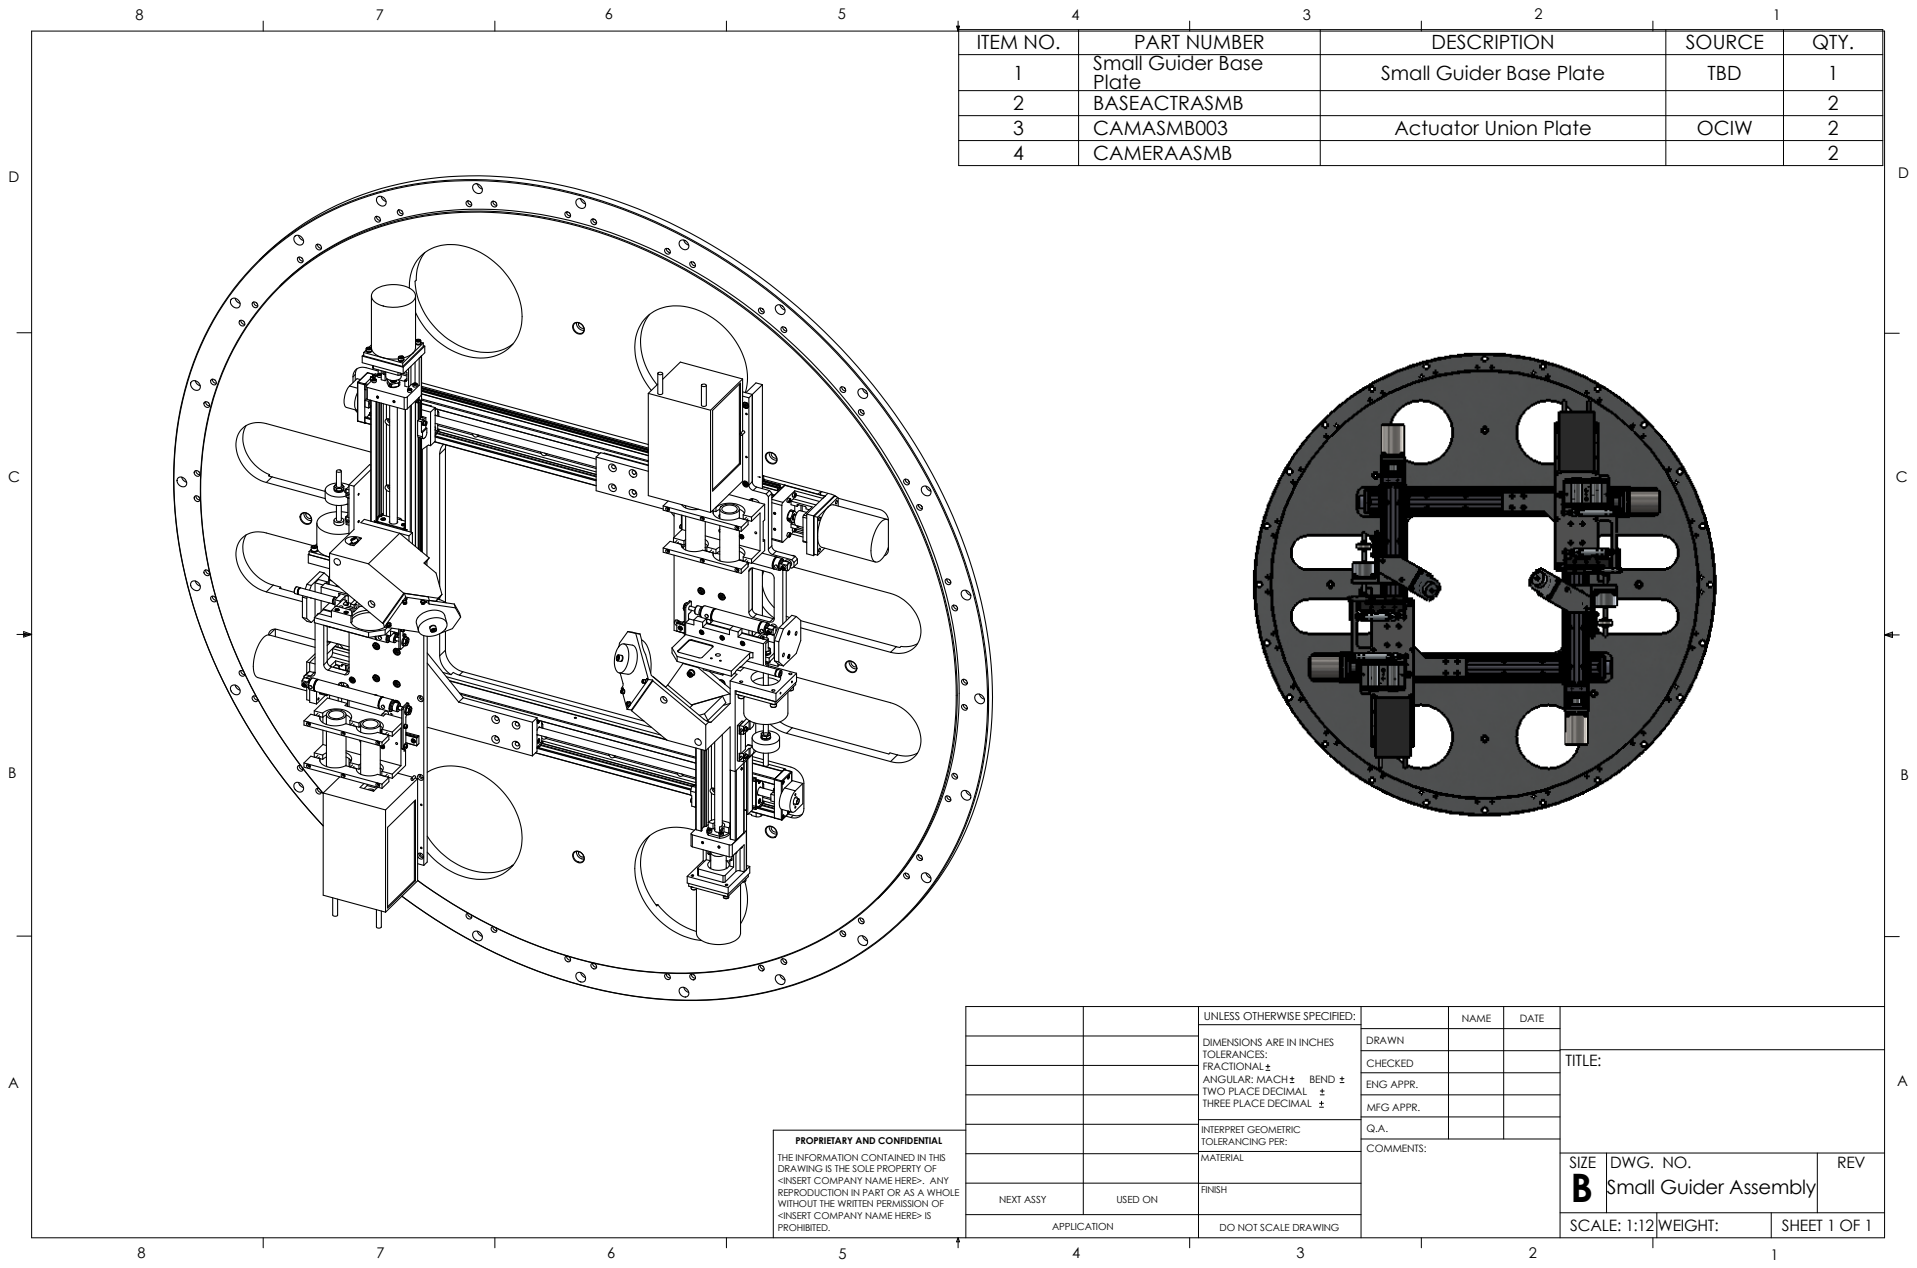
[picture p40: page 2]
SCALE: 1:12 WEIGHT:; REV; REPRODUCTION IN PART OR AS A WHOLE; COMMENTS:; MATERIAL; ANGULAR: MACH; BEND

ITEM NO. | PART NUMBER | DESCRIPTION | SOURCE | QTY.
1 | Small Guider Base Plate | Small Guider Base Plate | TBD | 1

2 | BASEACTRASMB | | | 2
3 | CAMASMB003 | Actuator Union Plate | OCIW | 2
4 | CAMERAASMB | | | 2

UNLESS OTHERWISE SPECIFIED: | | NAME | DATE

DIMENSIONS ARE IN INCHES
TOLERANCES:
FRACTIONAL
TWO PLACE DECIMAL
THREE PLACE DECIMAL

DRAWN
CHECKED | | | TITLE:

ENG APPR.

MFG APPR.

INTERPRET GEOMETRIC TOLERANCING PER: | Q.A.

PROPRIETARY AND CONFIDENTIAL
THE INFORMATION CONTAINED IN THIS
SIZE DRAWING IS THE SOLE PROPERTY OF

DWG. NO.
Small Guider Assembly

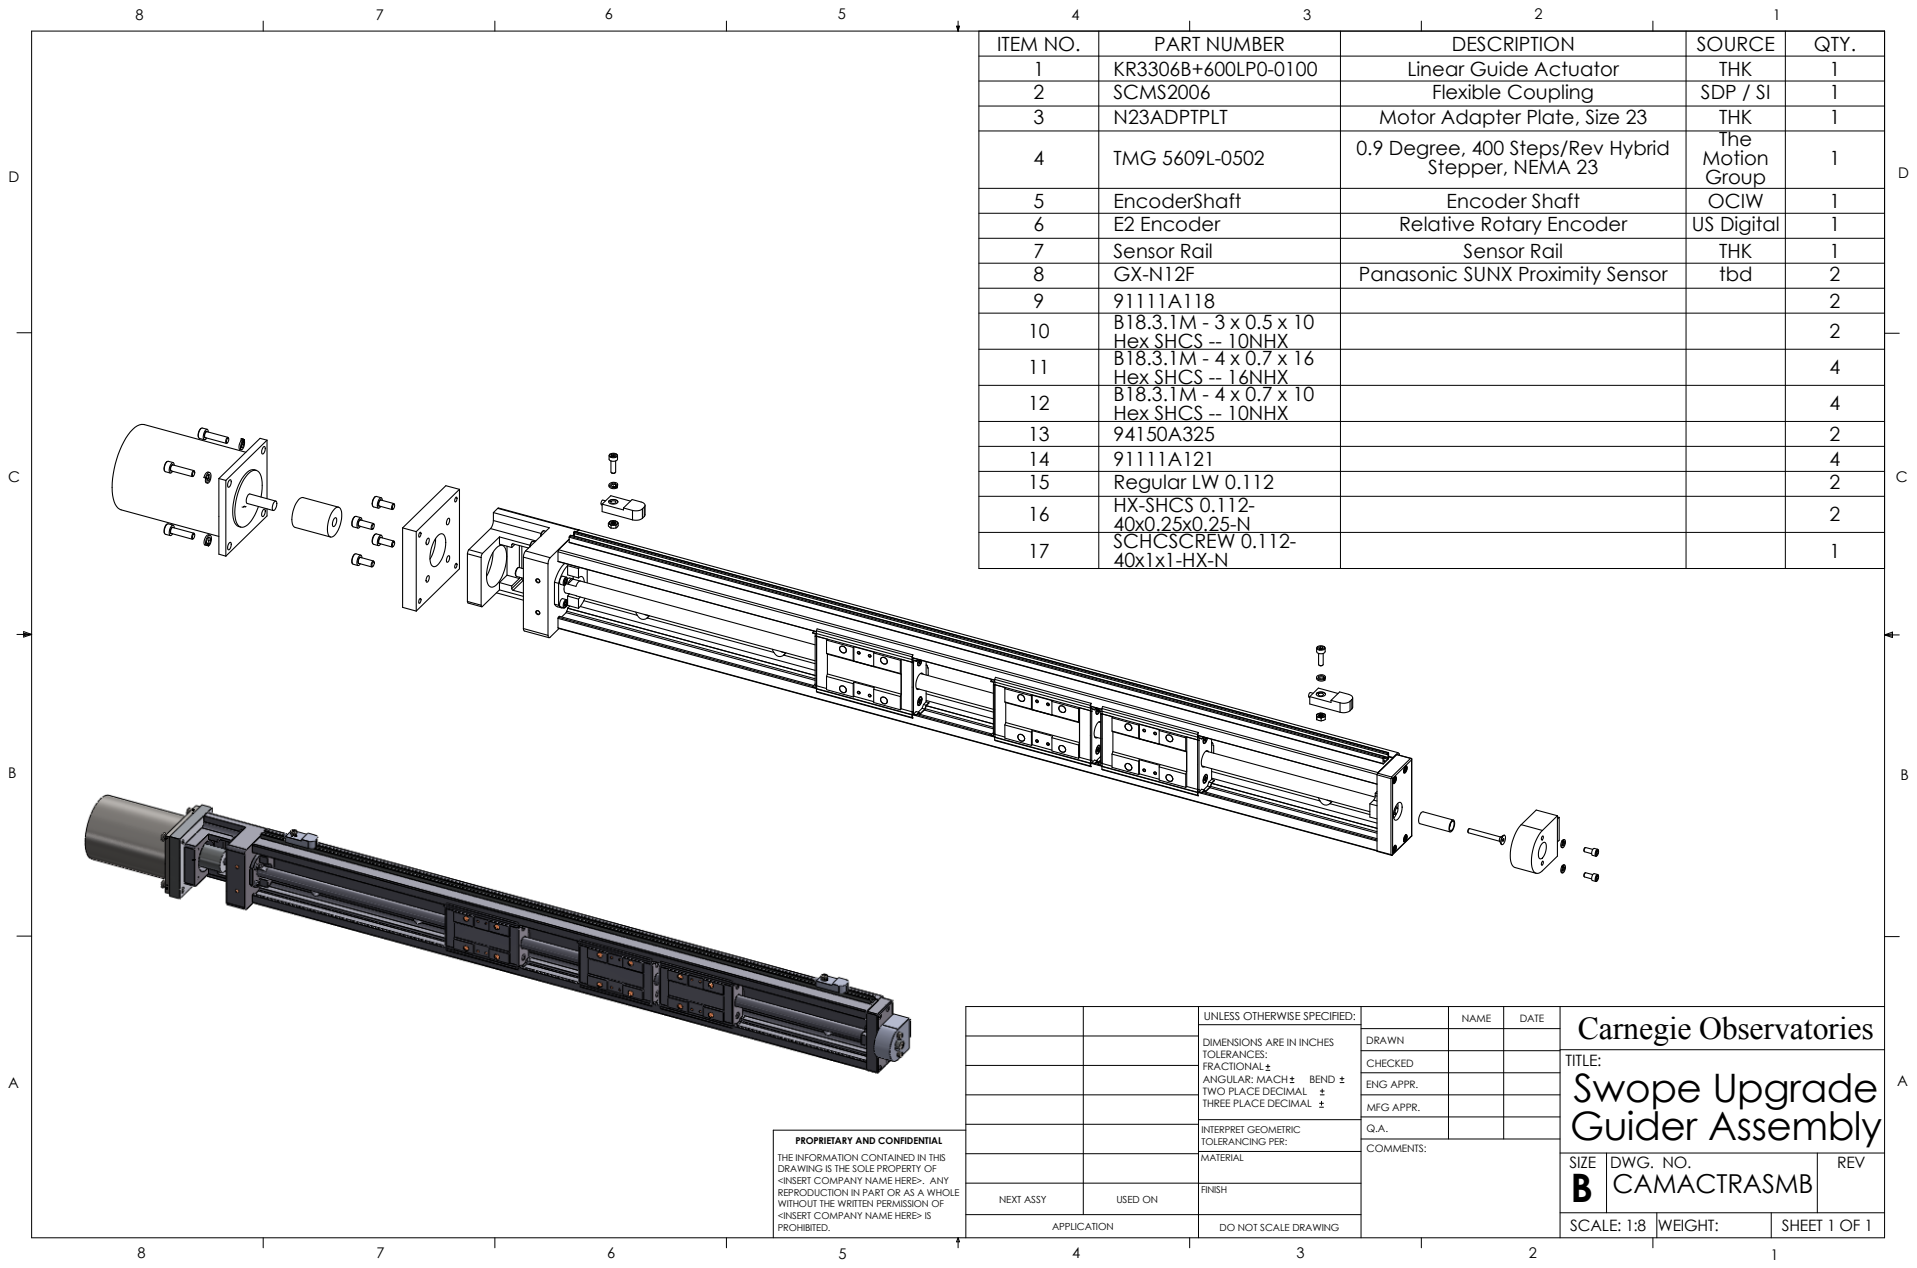
[picture p41: page 3]
INTERPRET GEOMETRIC; Guider Assembly; TITLE:; TOLERANCING PER:; CHECKED; COMMENTS:; ANGULAR: MACH; BEND; TWO PLACE DECIMAL; Swope Upgrade

1 | KR3306B+600LP0-0100 | Linear Guide Actuator | THK | 1
2 | SCMS2006 | Flexible Coupling | SDP / SI | 1
3 | N23ADPTPLT | Motor Adapter Plate, Size 23 | THK | 1
4 | TMG 5609L-0502 | 0.9 Degree, 400 Steps/Rev Hybrid Stepper, NEMA 23 | The Motion Group | 1

5 | EncoderShaft | Encoder Shaft | OCIW | 1
6 | E2 Encoder | Relative Rotary Encoder | US Digital | 1
7 | Sensor Rail | Sensor Rail | THK | 1
8 | GX-N12F | Panasonic SUNX Proximity Sensor | tbd | 2
9 | 91111A118 | | | 2
10 B18.3.1M - 3 x 0.5 x 10 | Hex SHCS -- 10NHX | | | 2

11 B18.3.1M - 4 x 0.7 x 16 | Hex SHCS -- 16NHX | | | 4

12 B18.3.1M - 4 x 0.7 x 10 | Hex SHCS -- 10NHX | | | 4

13 | 94150A325 | | | 2
14 | 91111A121 | | | 4
15 | Regular LW 0.112 | | | 2
16 HX-SHCS 0.112- | 40x0.25x0.25-N | | | 2

17 SCHCSCREW 0.112- | 40x1x1-HX-N | | | 1

UNLESS OTHERWISE SPECIFIED: | | NAME | DATE | Carnegie Observatories

DIMENSIONS ARE IN INCHES
TOLERANCES:
FRACTIONAL

DRAWN

ENG APPR.

THREE PLACE DECIMAL

MFG APPR.

PROPRIETARY AND CONFIDENTIAL
THE INFORMATION CONTAINED IN THIS
DRAWING IS THE SOLE PROPERTY OF

MATERIAL | | SIZE B CAMACTRASMB | DWG. NO. | REV

REPRODUCTION IN PART OR AS A WHOLE

NEXT ASSY | USED ON

SCALE: 1:8 | WEIGHT: | SHEET 1 OF 1

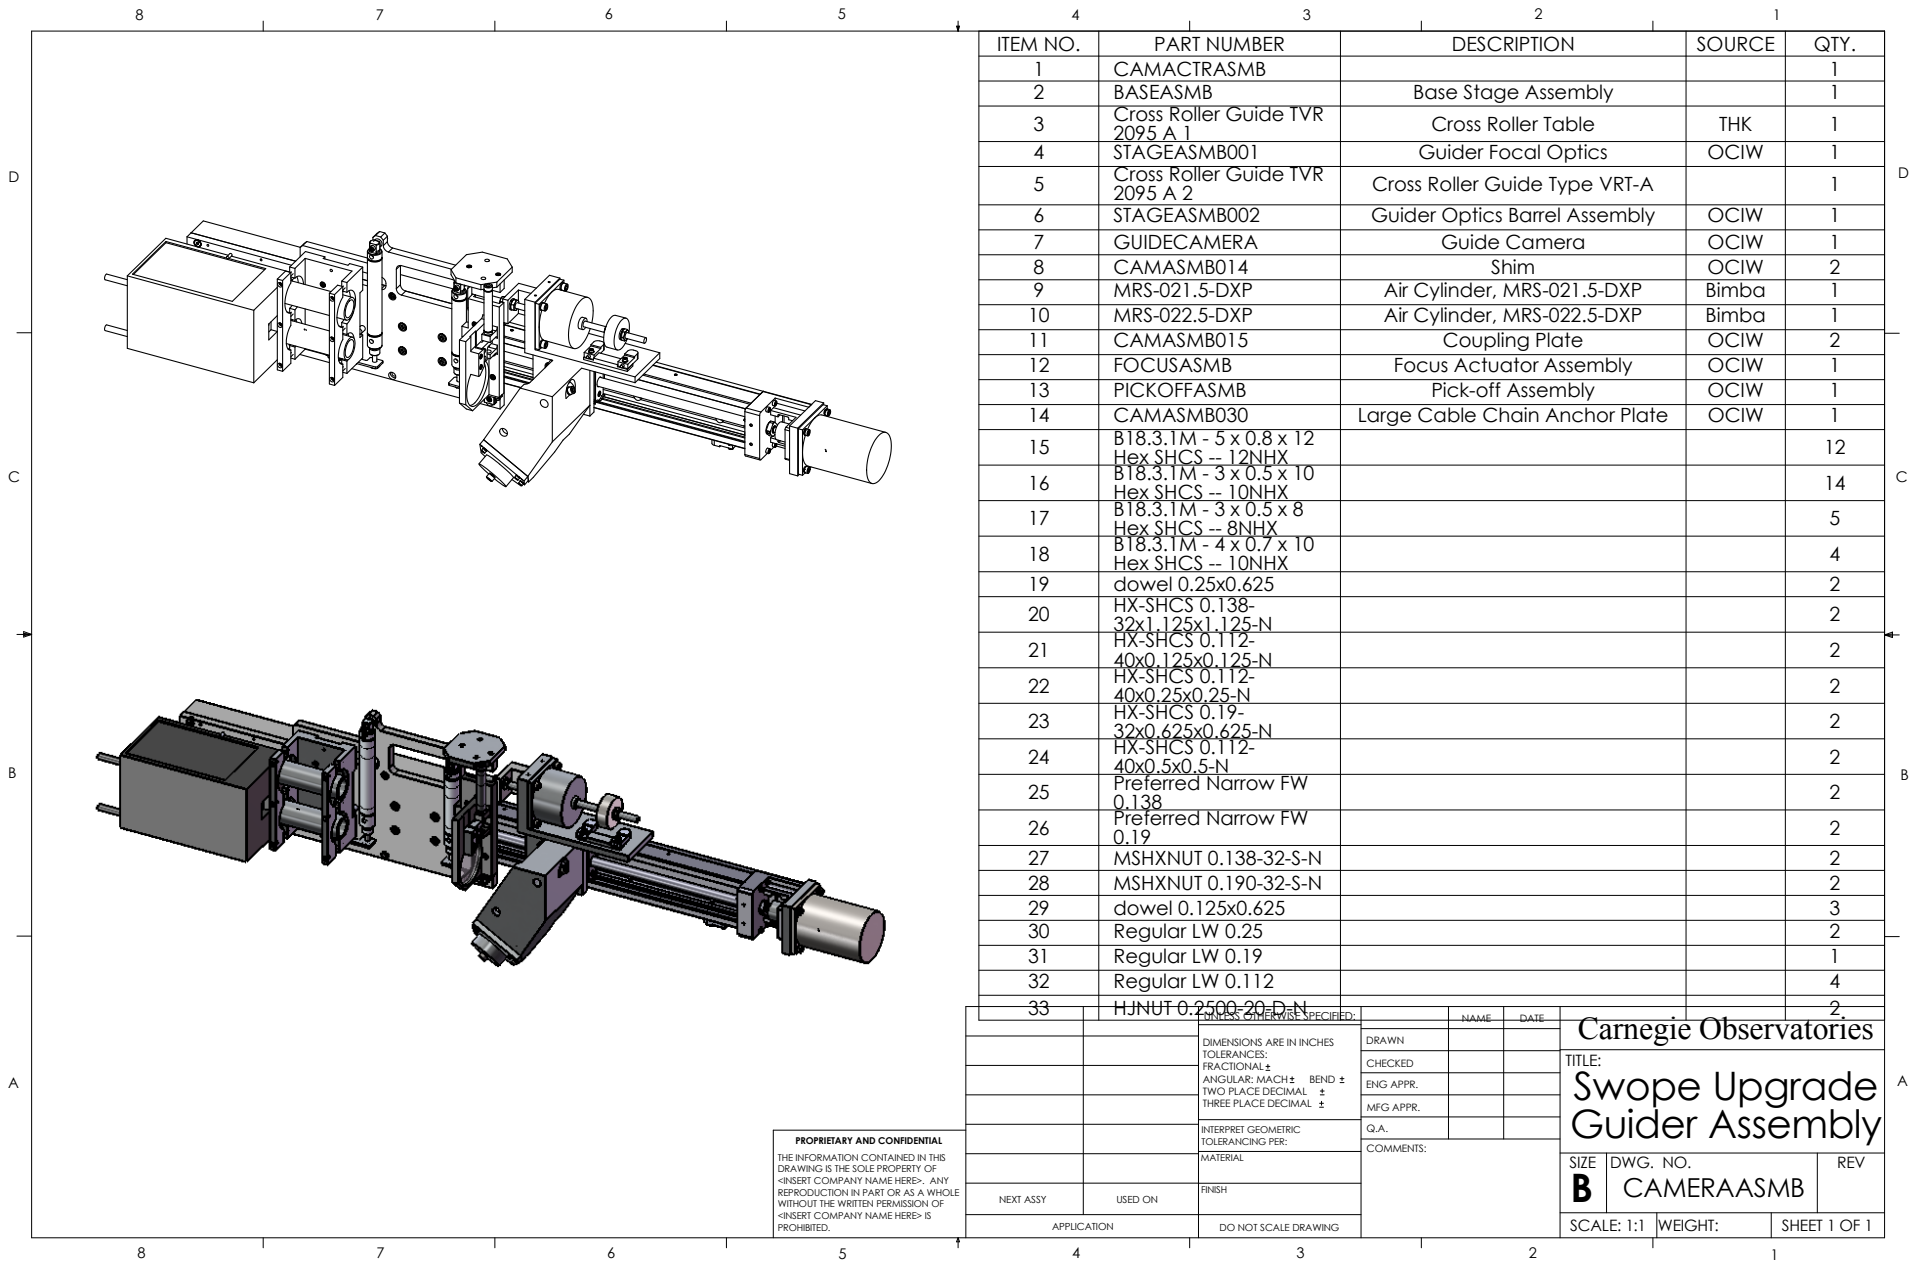
[picture p42: page 4]
DCB; BCD; WEIGHT:; SCALE: 1:1; REV; REPRODUCTION IN PART OR AS A WHOLE; CAMERAASMB; DWG. NO. DRAWING IS THE SOLE PROPERTY OF; B <INSERT COMPANY NAME HERE> IS; SIZE; MATERIAL; COMMENTS:

1 CAMACTRASMB
2 | BASEASMB | Base Stage Assembly | 1 3

Cross Roller Guide TVR 2095 A 1 | Cross Roller Table | THK | 1

4 | STAGEASMB001 | Guider Focal Optics | OCIW | 1 5

Cross Roller Guide TVR 2095 A 2 | Cross Roller Guide Type VRT-A | | 1

6 | STAGEASMB002 | Guider Optics Barrel Assembly | OCIW | 1
7 | GUIDECAMERA | Guide Camera | OCIW | 1
8 | CAMASMB014 | Shim | OCIW | 2
9 | MRS-021.5-DXP | Air Cylinder, MRS-021.5-DXP | Bimba | 1
10 | MRS-022.5-DXP | Air Cylinder, MRS-022.5-DXP | Bimba | 1
11 | CAMASMB015 | Coupling Plate | OCIW | 2
12 | FOCUSASMB | Focus Actuator Assembly | OCIW | 1
13 | PICKOFFASMB | Pick-off Assembly | OCIW | 1
14 | CAMASMB030 | Large Cable Chain Anchor Plate | OCIW | 1
15 B18.3.1M - 5 x 0.8 x 12 | Hex SHCS -- 12NHX | | | 12
16 B18.3.1M - 3 x 0.5 x 10 | Hex SHCS -- 10NHX | | | 14
17 B18.3.1M - 3 x 0.5 x 8 | Hex SHCS -- 8NHX | | | 5
18 B18.3.1M - 4 x 0.7 x 10 | Hex SHCS -- 10NHX | | | 4

19 dowel 0.25x0.625 | | | | 2
20 HX-SHCS 0.138- | 32x1.125x1.125-N | | | 2
21 HX-SHCS 0.112- | 40x0.125x0.125-N | | | 2
22 HX-SHCS 0.112- | 40x0.25x0.25-N | | | 2
23 HX-SHCS 0.19- | 32x0.625x0.625-N | | | 2
24 HX-SHCS 0.112- | 40x0.5x0.5-N | | | 2
25 Preferred Narrow FW | 0.138 | | | 2
26 Preferred Narrow FW | 0.19 | | | 2

27 MSHXNUT 0.138-32-S-N | | | | 2
28 MSHXNUT 0.190-32-S-N | | | | 2
29 dowel 0.125x0.625 | | | | 3
30 Regular LW 0.25 | | | | 2
31 Regular LW 0.19 | | | | 1
32 Regular LW 0.112 | | | | 4
33 HJNUT 0.2500-20-D-N | UNLESS OTHERWISE SPECIFIED: | NAME | DATE | | 2

DIMENSIONS ARE IN INCHES TOLERANCES: FRACTIONAL ANGULAR: MACH TWO PLACE DECIMAL BEND THREE PLACE DECIMAL | | | Carnegie Observatories
CHECKED | TITLE: Swope Upgrade Guider Assembly

DRAWN

ENG APPR.

MFG APPR.

INTERPRET GEOMETRIC TOLERANCING PER: | Q.A.

PROPRIETARY AND CONFIDENTIAL
THE INFORMATION CONTAINED IN THIS

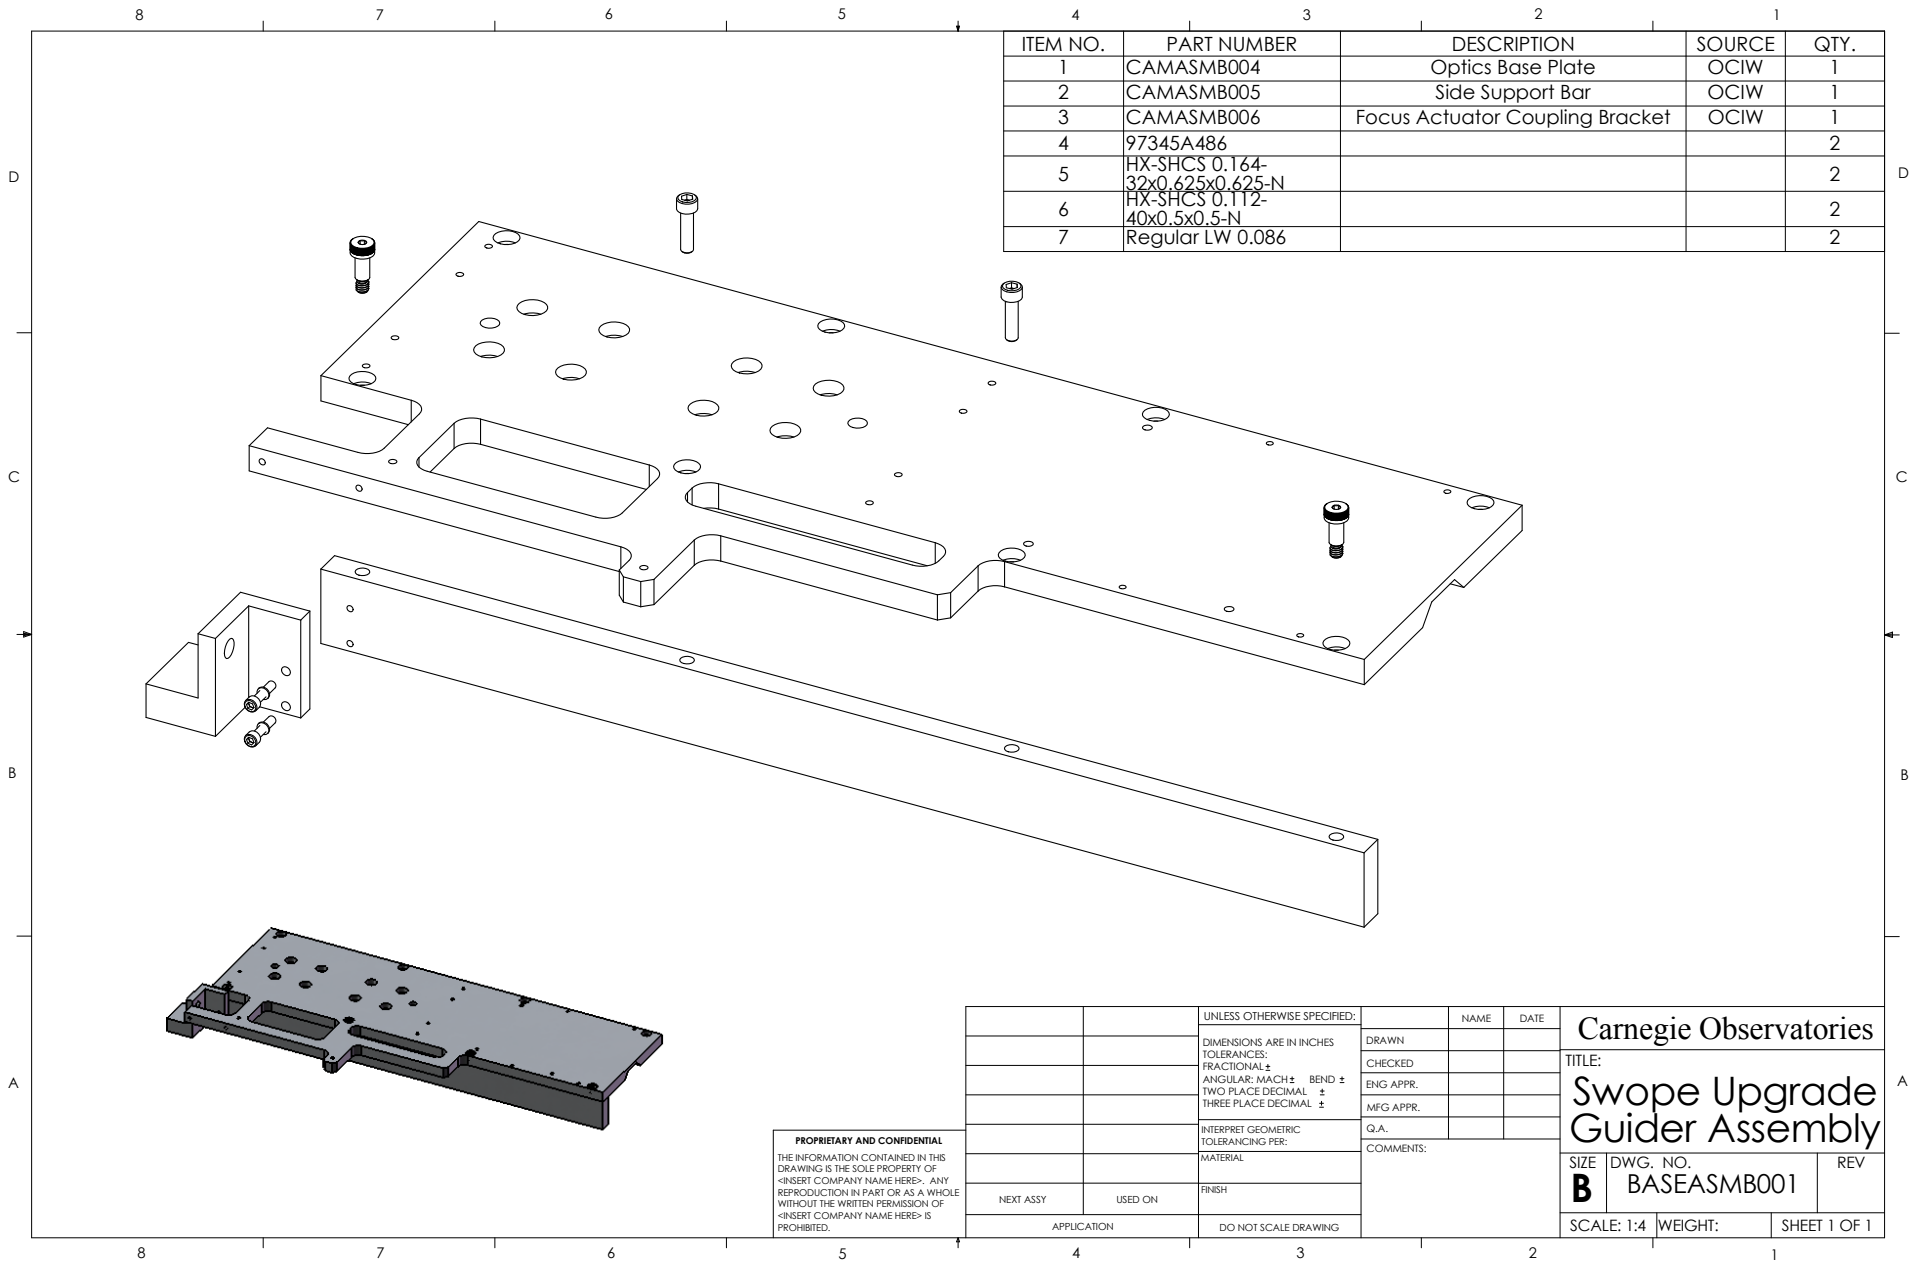
[picture p43: page 5]
Guider Assembly; REV; REPRODUCTION IN PART OR AS A WHOLE; BASEASMB001; SIZE; TITLE:; MATERIAL; CHECKED; COMMENTS:; ANGULAR: MACH; BEND; TWO PLACE DECIMAL; Swope Upgrade

1 | CAMASMB004 | Optics Base Plate | OCIW | 1
2 | CAMASMB005 | Side Support Bar | OCIW | 1
3 | CAMASMB006 | Focus Actuator Coupling Bracket | OCIW | 1
4 | 97345A486 | | | 2
5 | HX-SHCS 0.164-32x0.625x0.625-N | | | 2
6 | HX-SHCS 0.112-40x0.5x0.5-N | | | 2

7 | Regular LW 0.086 | | | 2

UNLESS OTHERWISE SPECIFIED: | | NAME | DATE | Carnegie Observatories

DIMENSIONS ARE IN INCHES
TOLERANCES:
FRACTIONAL

DRAWN

ENG APPR.

THREE PLACE DECIMAL

MFG APPR.

INTERPRET GEOMETRIC TOLERANCING PER: | Q.A.

PROPRIETARY AND CONFIDENTIAL
THE INFORMATION CONTAINED IN THIS
DWG. NO. DRAWING IS THE SOLE PROPERTY OF

B <INSERT COMPANY NAME HERE> IS

SCALE: 1:4

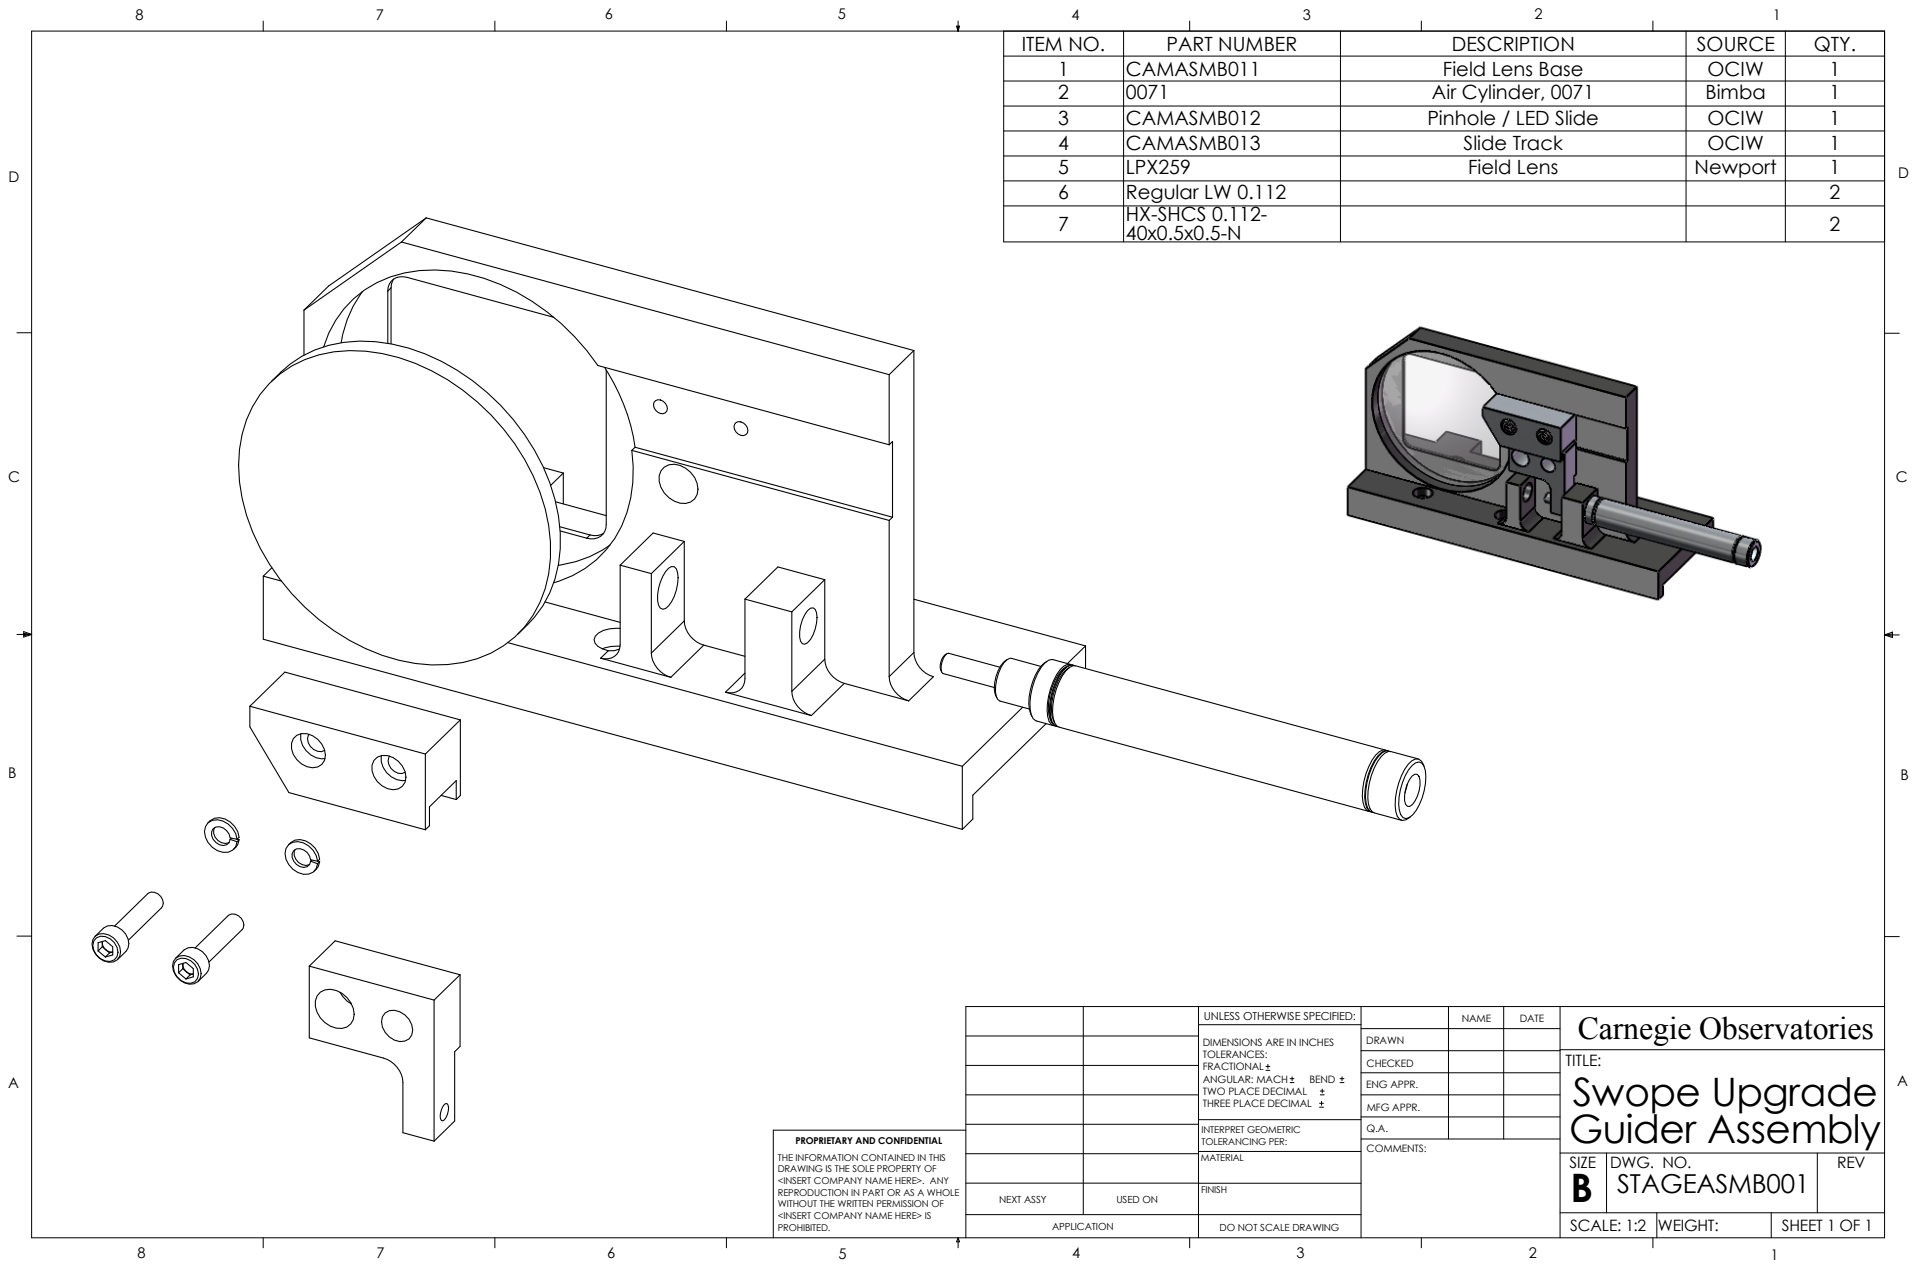
[picture p44: page 6]
STAGEASMB001; REV; Guider Assembly; WITHOUT THE WRITTEN PERMISSION OF; SIZE; TITLE:; MATERIAL; CHECKED; COMMENTS:; ANGULAR: MACH; BEND; TWO PLACE DECIMAL; Swope Upgrade

1 | CAMASMB011 | Field Lens Base | OCIW | 1
2 | 0071 | Air Cylinder, 0071 | Bimba | 1
3 | CAMASMB012 | Pinhole / LED Slide | OCIW | 1
4 | CAMASMB013 | Slide Track | OCIW | 1
5 | LPX259 | Field Lens | Newport | 1
6 | Regular LW 0.112 | | | 2
7 | HX-SHCS 0.112-40x0.5x0.5-N | | | 2

UNLESS OTHERWISE SPECIFIED: | | NAME | DATE | Carnegie Observatories

DIMENSIONS ARE IN INCHES
TOLERANCES:
FRACTIONAL

DRAWN

ENG APPR.

THREE PLACE DECIMAL

MFG APPR.

INTERPRET GEOMETRIC TOLERANCING PER: | Q.A.

PROPRIETARY AND CONFIDENTIAL
THE INFORMATION CONTAINED IN THIS
DWG. NO. DRAWING IS THE SOLE PROPERTY OF

REPRODUCTION IN PART OR AS A WHOLE

NEXT ASSY | USED ON

APPLICATION | | SCALE: 1:2 | SHEET 1 OF 1

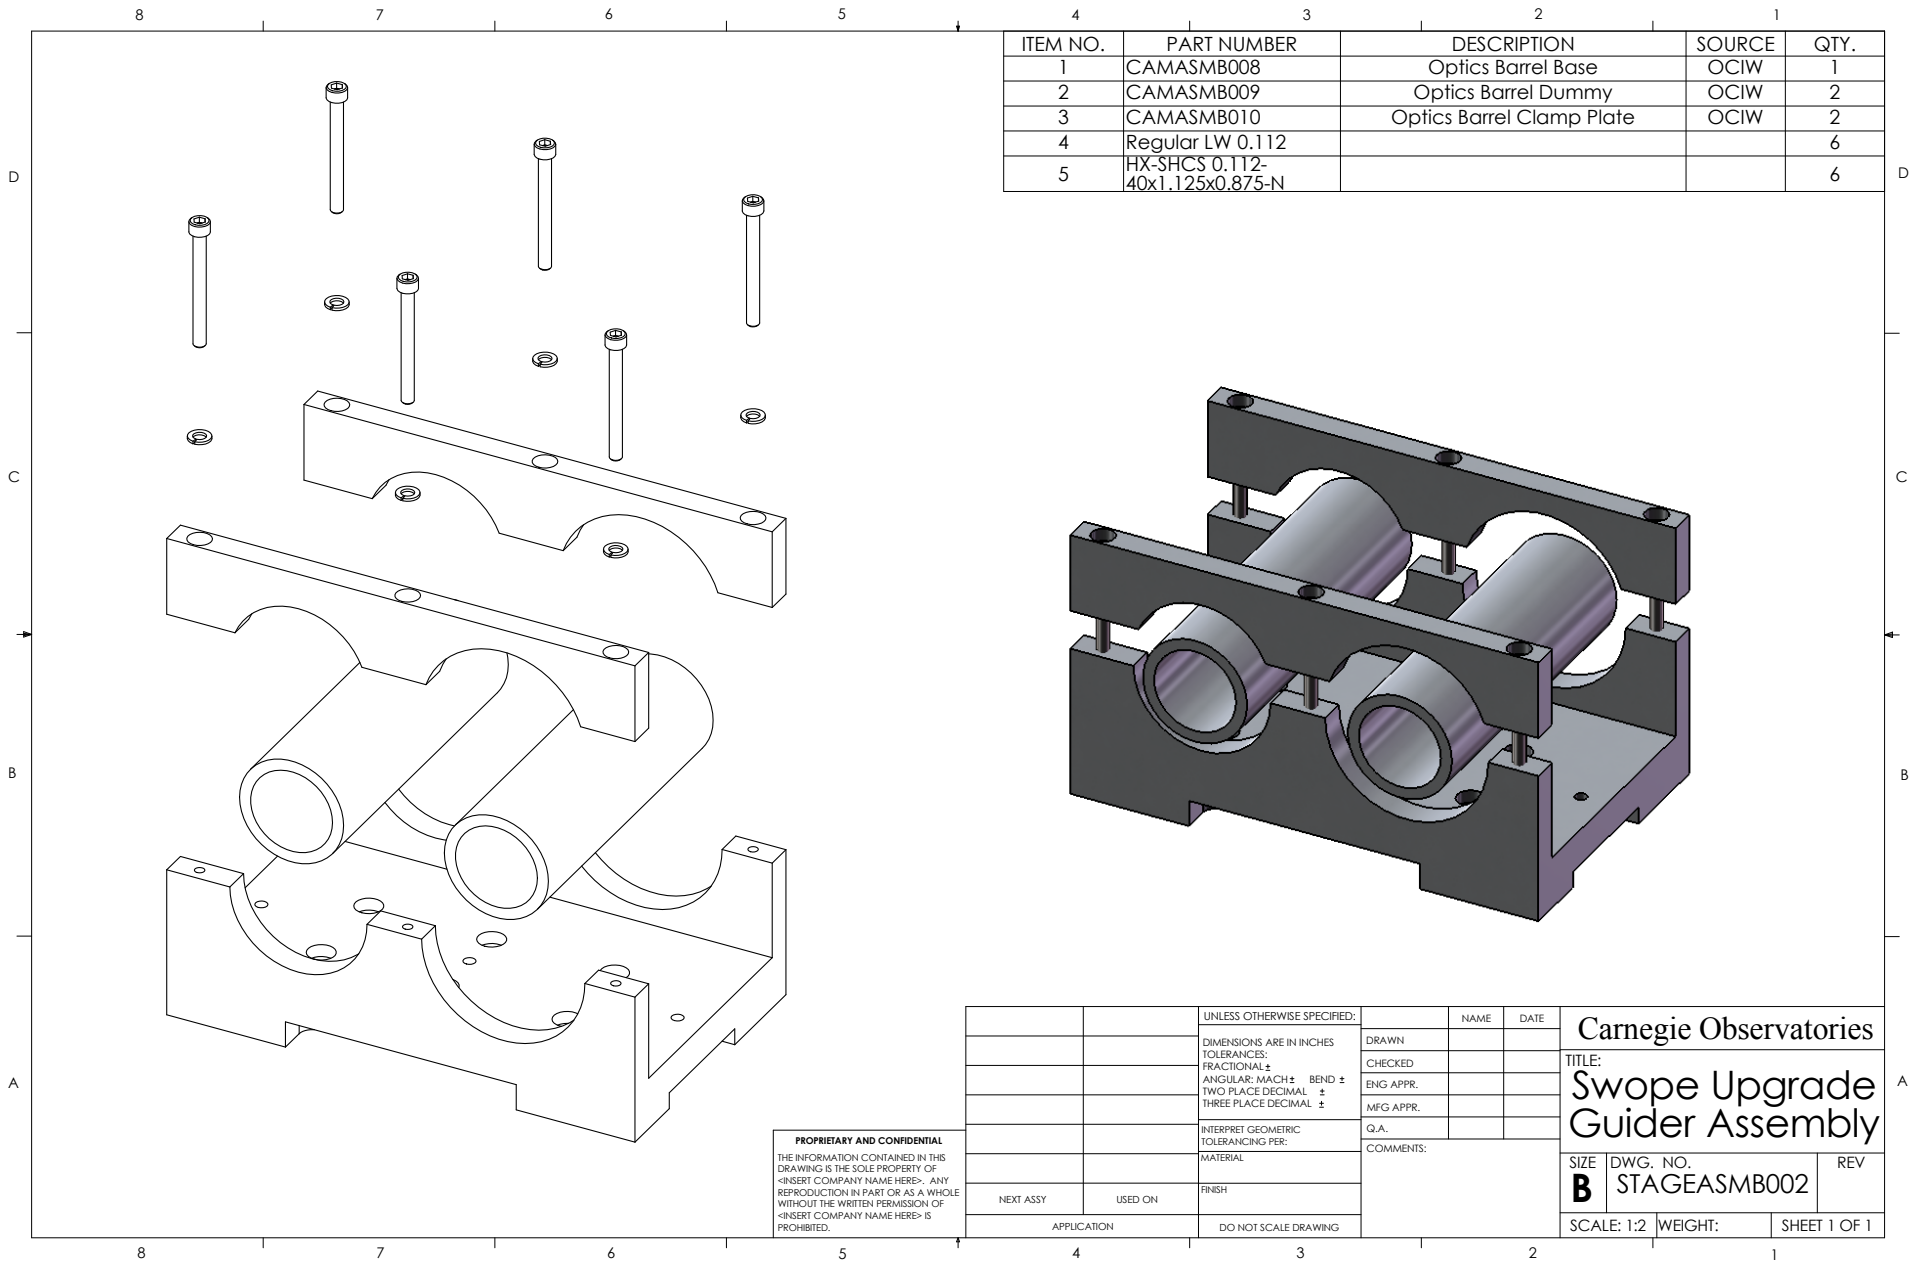
[picture p45: page 7]
Guider Assembly; REV; REPRODUCTION IN PART OR AS A WHOLE; STAGEASMB002; SIZE; TITLE:; MATERIAL; CHECKED; COMMENTS:; ANGULAR: MACH; BEND; TWO PLACE DECIMAL; Swope Upgrade

1 | CAMASMB008 | Optics Barrel Base | OCIW | 1
2 | CAMASMB009 | Optics Barrel Dummy | OCIW | 2
3 | CAMASMB010 | Optics Barrel Clamp Plate | OCIW | 2
4 | Regular LW 0.112 | | | 6
5 | HX-SHCS 0.112-40x1.125x0.875-N | | | 6

UNLESS OTHERWISE SPECIFIED: | | NAME | DATE | Carnegie Observatories

DIMENSIONS ARE IN INCHES
TOLERANCES:
FRACTIONAL

DRAWN

ENG APPR.

THREE PLACE DECIMAL

MFG APPR.

INTERPRET GEOMETRIC TOLERANCING PER: | Q.A.

PROPRIETARY AND CONFIDENTIAL
THE INFORMATION CONTAINED IN THIS
DWG. NO. DRAWING IS THE SOLE PROPERTY OF

B <INSERT COMPANY NAME HERE> IS

SCALE: 1:2

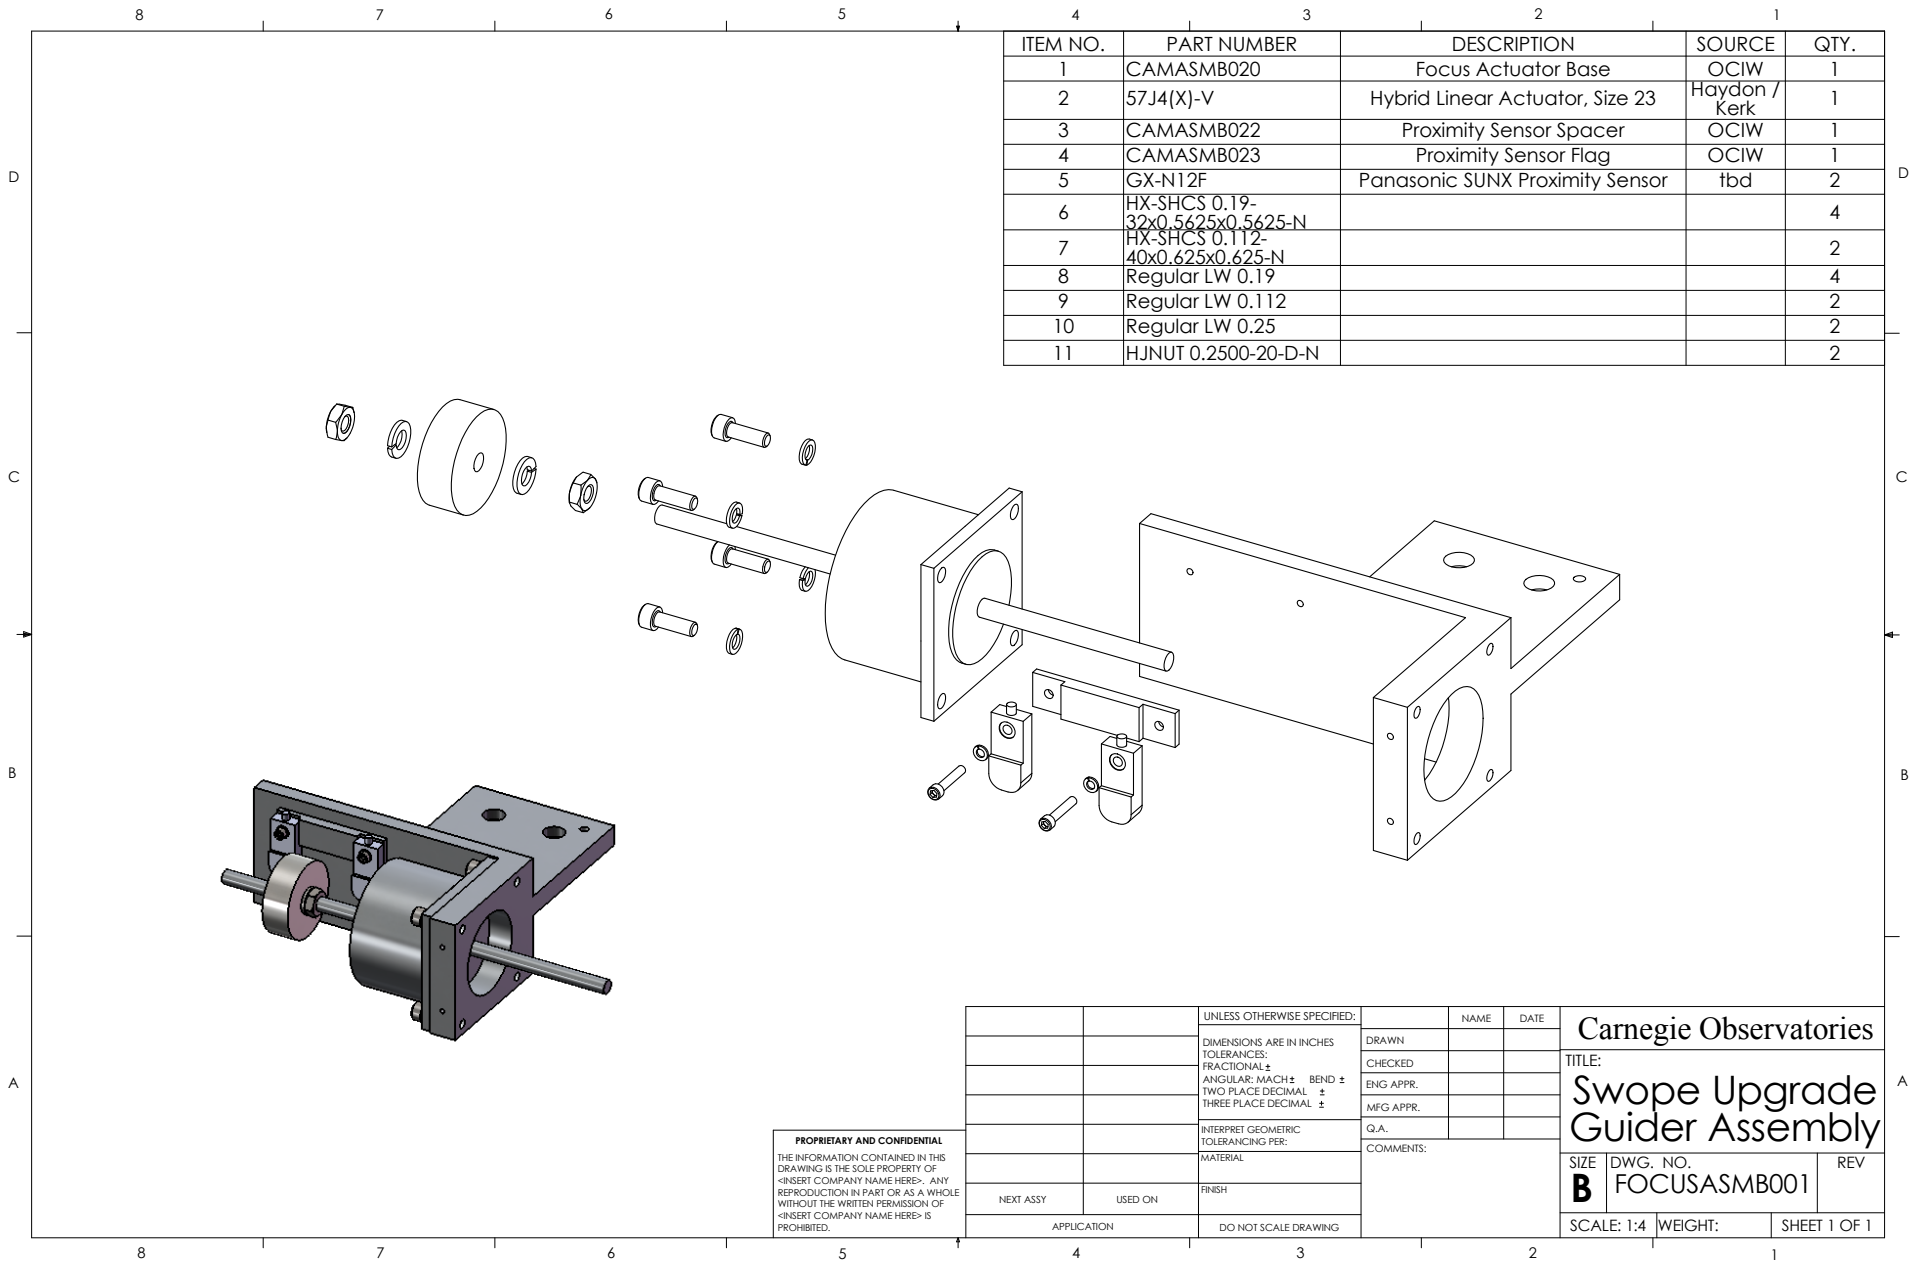
[picture p46: page 8]
Guider Assembly; REV; REPRODUCTION IN PART OR AS A WHOLE; FOCUSASMB001; SIZE; TITLE:; MATERIAL; CHECKED; COMMENTS:; ANGULAR: MACH; BEND; TWO PLACE DECIMAL; Swope Upgrade

1 | CAMASMB020 | Focus Actuator Base | OCIW | 1
2 | 57J4(X)-V | Hybrid Linear Actuator, Size 23 | Haydon / Kerk | 1

3 | CAMASMB022 | Proximity Sensor Spacer | OCIW | 1
4 | CAMASMB023 | Proximity Sensor Flag | OCIW | 1
5 | GX-N12F | Panasonic SUNX Proximity Sensor | tbd | 2
6 | HX-SHCS 0.19-32x0.5625x0.5625-N | | | 4
7 | HX-SHCS 0.112-40x0.625x0.625-N | | | 2

8 | Regular LW 0.19 | | | 4
9 | Regular LW 0.112 | | | 2
10 | Regular LW 0.25 | | | 2
11 | HJNUT 0.2500-20-D-N | | | 2

UNLESS OTHERWISE SPECIFIED: | | NAME | DATE | Carnegie Observatories

DIMENSIONS ARE IN INCHES
TOLERANCES:
FRACTIONAL

DRAWN

ENG APPR.

THREE PLACE DECIMAL

MFG APPR.

INTERPRET GEOMETRIC TOLERANCING PER: | Q.A.

PROPRIETARY AND CONFIDENTIAL
THE INFORMATION CONTAINED IN THIS
DWG. NO. DRAWING IS THE SOLE PROPERTY OF

B <INSERT COMPANY NAME HERE> IS

SCALE: 1:4

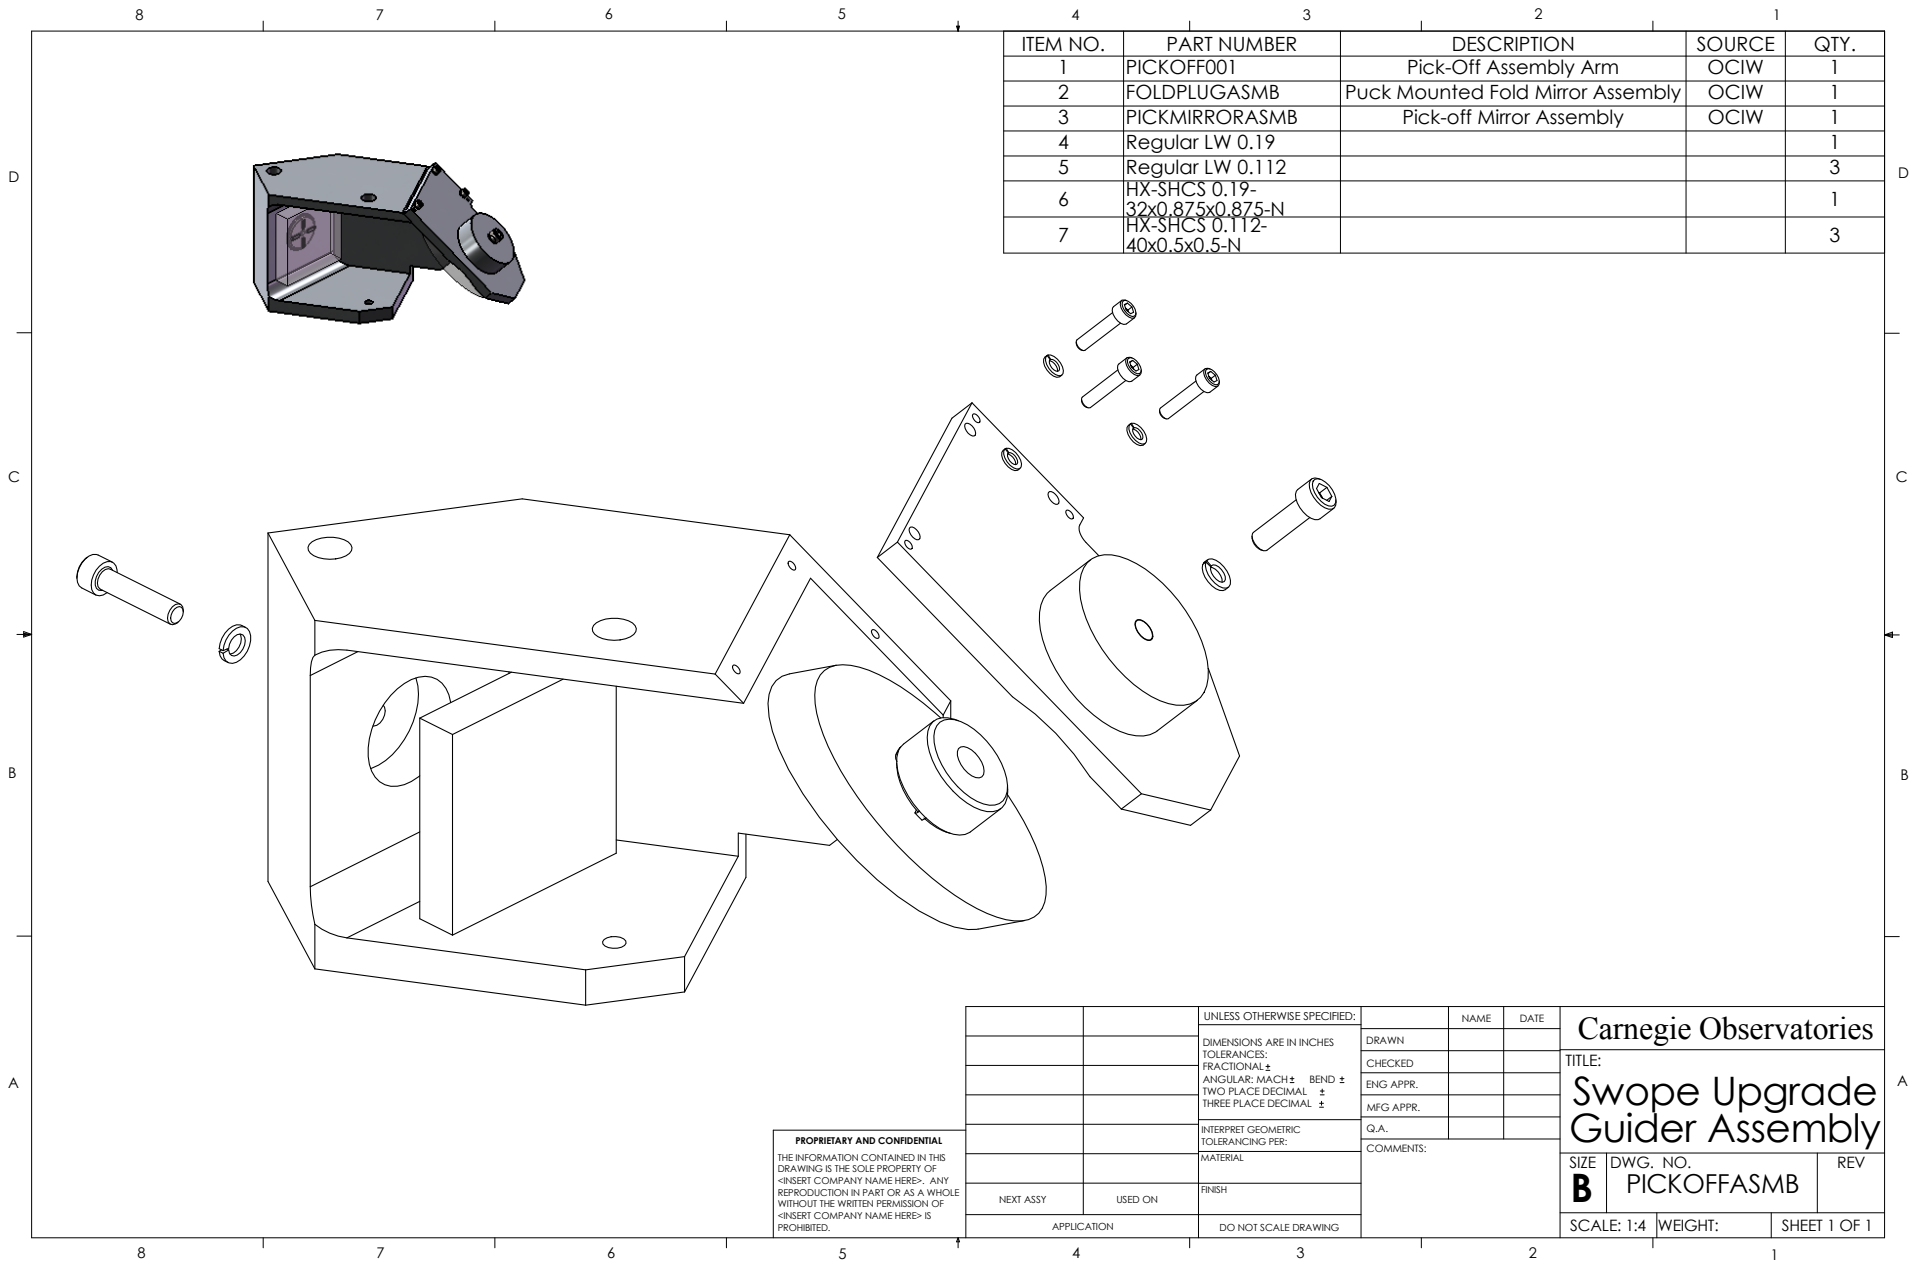
[picture p47: page 9]
PICKOFFASMB; Guider Assembly; DRAWING IS THE SOLE PROPERTY OF; DWG. NO.; REV; WITHOUT THE WRITTEN PERMISSION OF; SIZE; TITLE:; MATERIAL; CHECKED; COMMENTS:; ANGULAR: MACH; BEND; TWO PLACE DECIMAL; Swope Upgrade

1 | PICKOFF001 | Pick-Off Assembly Arm | OCIW | 1
2 | FOLDPLUGASMB | Puck Mounted Fold Mirror Assembly | OCIW | 1
3 | PICKMIRRORASMB | Pick-off Mirror Assembly | OCIW | 1
4 | Regular LW 0.19 | | | 1
5 | Regular LW 0.112 | | | 3
6 | HX-SHCS 0.19-32x0.875x0.875-N | | | 1

7 | HX-SHCS 0.112-40x0.5x0.5-N | | | 3

UNLESS OTHERWISE SPECIFIED: | | NAME | DATE | Carnegie Observatories

DIMENSIONS ARE IN INCHES
TOLERANCES:
FRACTIONAL

DRAWN

ENG APPR.

THREE PLACE DECIMAL

MFG APPR.

INTERPRET GEOMETRIC TOLERANCING PER: | Q.A.

PROPRIETARY AND CONFIDENTIAL
THE INFORMATION CONTAINED IN THIS

REPRODUCTION IN PART OR AS A WHOLE

NEXT ASSY | USED ON

SCALE: 1:4 | WEIGHT: | SHEET 1 OF 1

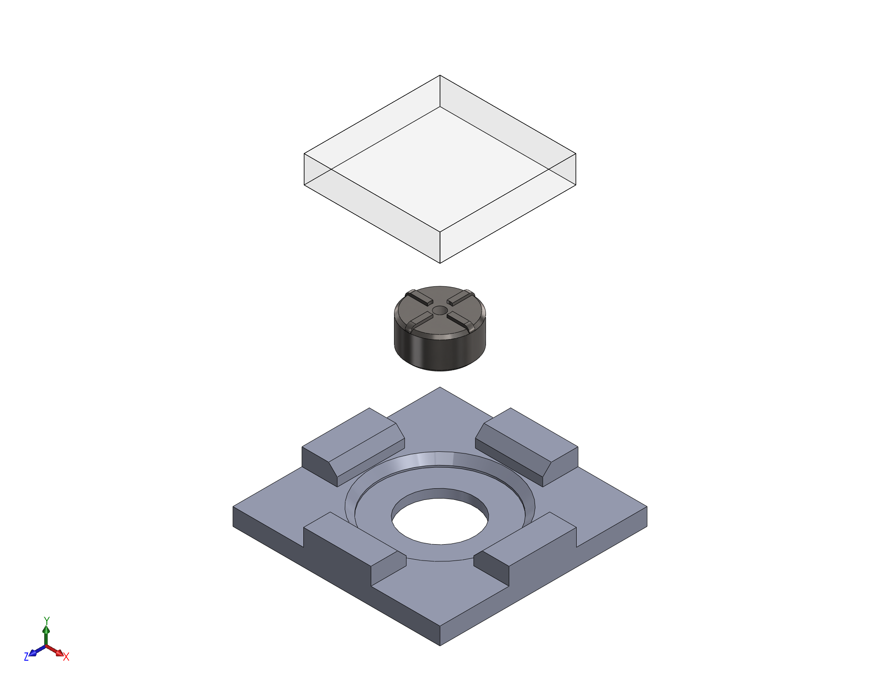
[picture p48: page 10]
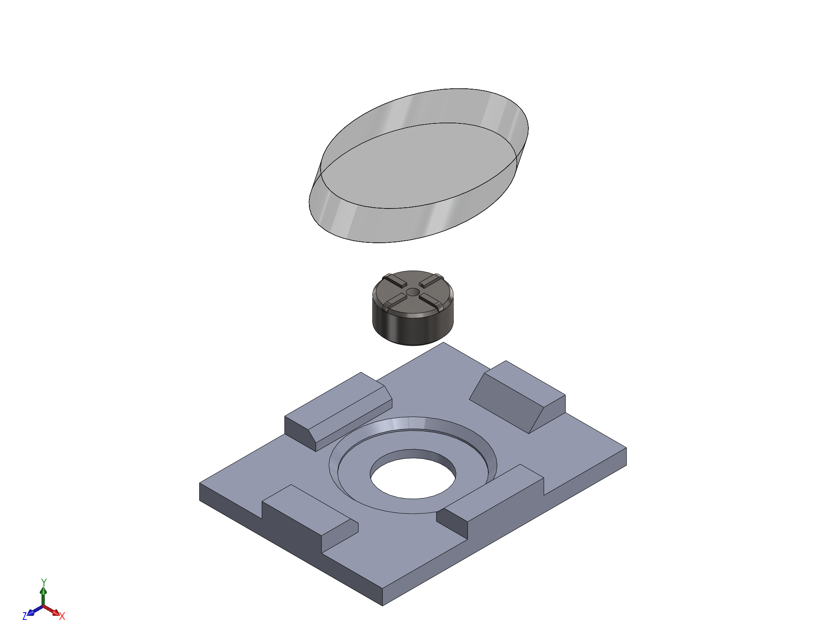
[picture p49: page 11]
