alanbagish/C40_upgrades/Documents/Hayden_Kerk Hybrid Linear Actuator/Wiring Diagram.jpg

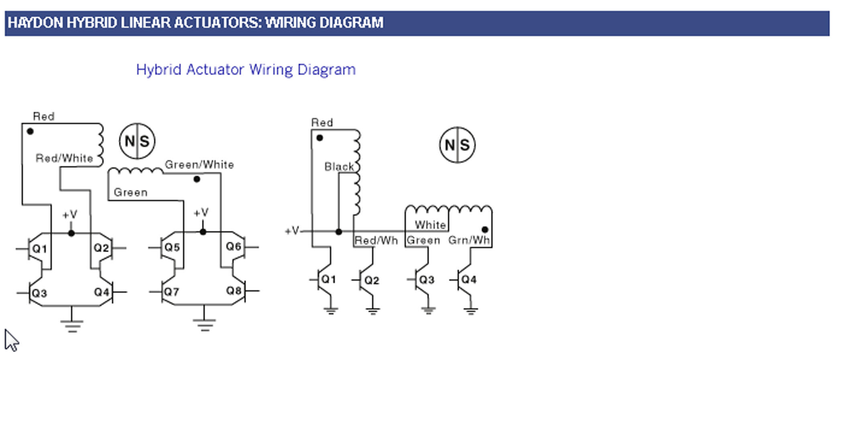
Documents/Hayden_Kerk Hybrid Linear Actuator/Wiring Diagram.jpg
