alanbagish/C40_upgrades/C40_Tyson_docs/2012 03 28 - Swope Upgrade Project.pdf

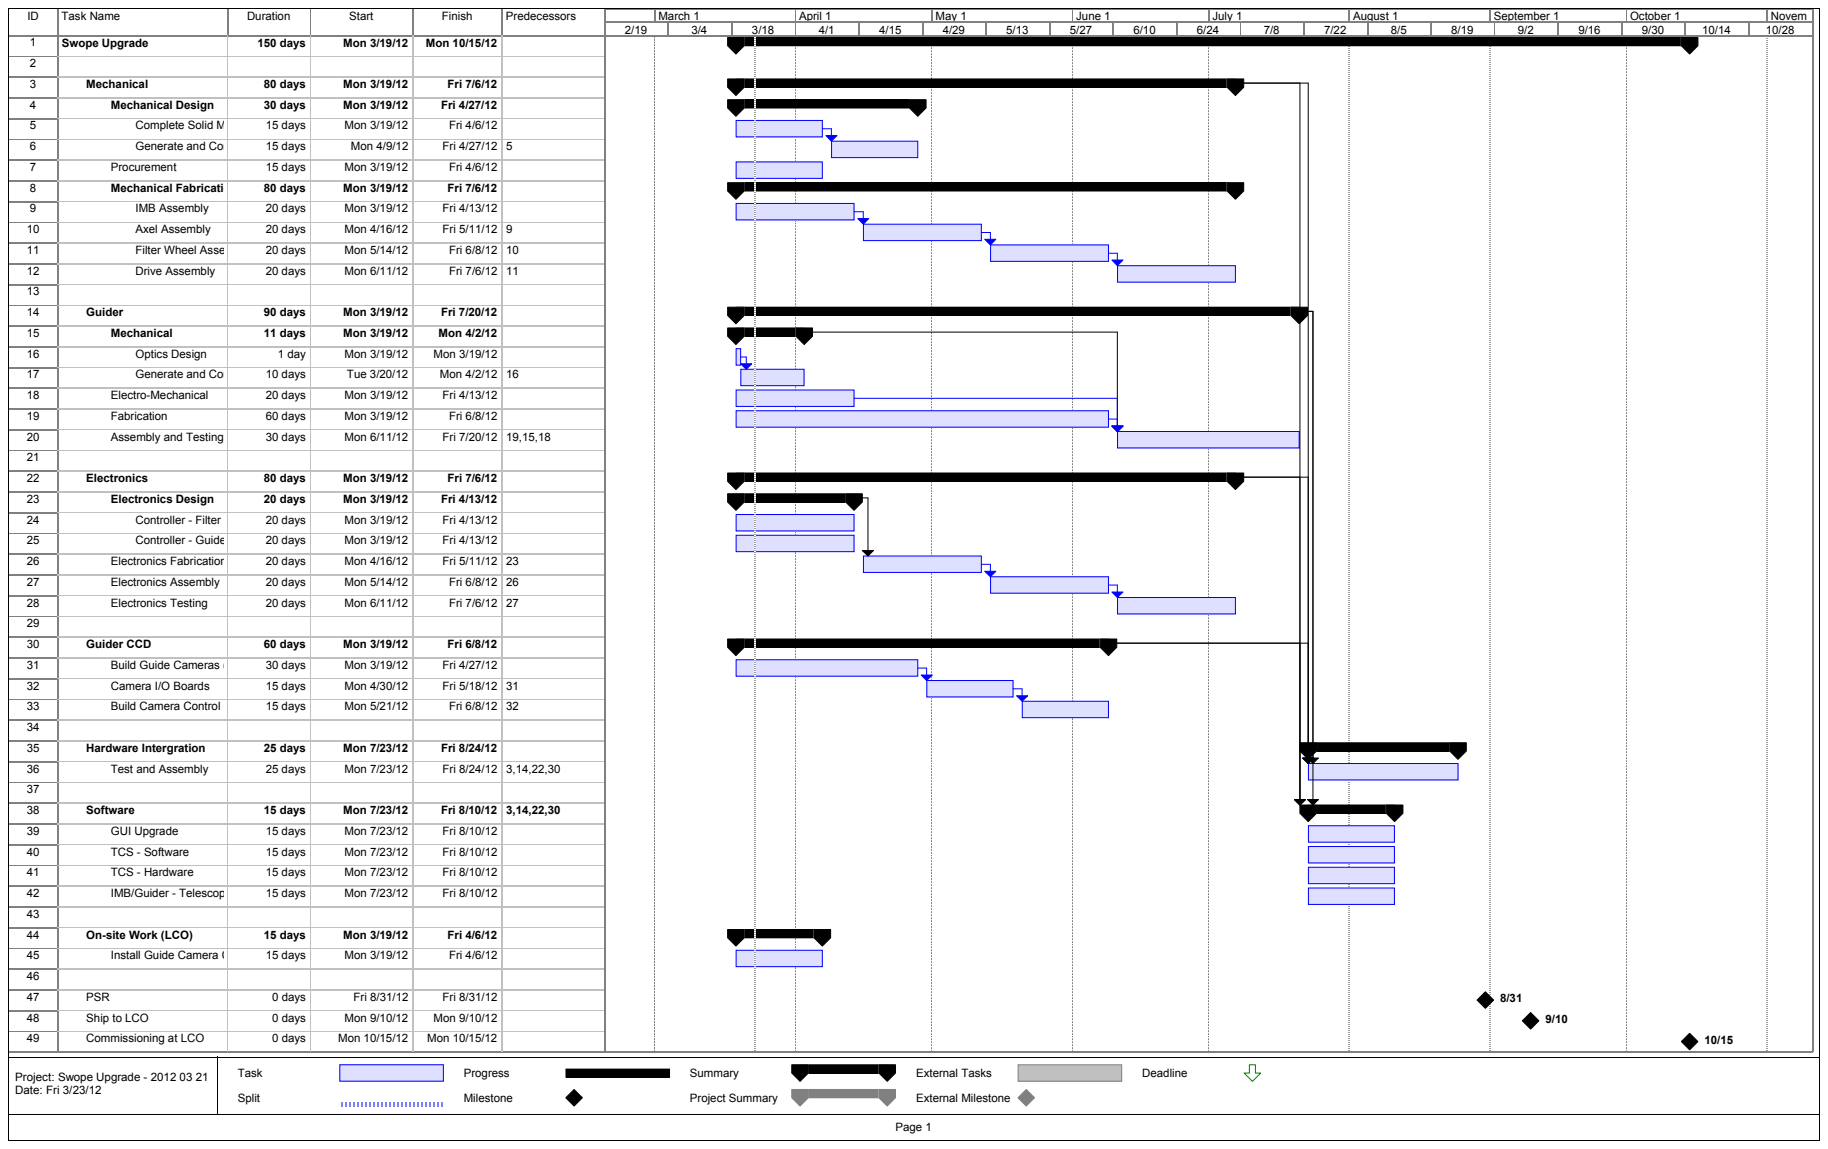
[picture p51: page 1]
Page 1

ID | Task Name | Duration | Start | Finish | Predecessors | | March 1 | April 1 | May 1 | June 1 | July 1 | August 1 | September 1 | October 1 | Novem

1 | Swope Upgrade | 150 days | Mon 3/19/12 | Mon 10/15/12

3 | Mechanical | 80 days | Mon 3/19/12 | Fri 7/6/12
4 | Mechanical Design | 30 days | Mon 3/19/12 | Fri 4/27/12
5 | Complete Solid Model | 15 days | Mon 3/19/12 | Fri 4/6/12
6 | Generate and Compile Fabrication Drawings 15 days | | Mon 4/9/12 | Fri 4/27/12 | 5
7 | Procurement | 15 days | Mon 3/19/12 | Fri 4/6/12
8 | Mechanical Fabrication | 80 days | Mon 3/19/12 | Fri 7/6/12
9 | IMB Assembly | 20 days | Mon 3/19/12 | Fri 4/13/12
10 | Axel Assembly | 20 days | Mon 4/16/12 | Fri 5/11/12 | 9
11 | Filter Wheel Assembly | 20 days | Mon 5/14/12 | Fri 6/8/12 | 10
12 | Drive Assembly | 20 days | Mon 6/11/12 | Fri 7/6/12 | 11
13
14 | Guider | 90 days | Mon 3/19/12 | Fri 7/20/12
15 | Mechanical | 11 days | Mon 3/19/12 | Mon 4/2/12
16 | Optics Design | 1 day | Mon 3/19/12 | Mon 3/19/12
17 | Generate and Compile Fabrication Drawings 10 days | | Tue 3/20/12 | Mon 4/2/12 | 16
18 | Electro-Mechanical | 20 days | Mon 3/19/12 | Fri 4/13/12
19 | Fabrication | 60 days | Mon 3/19/12 | Fri 6/8/12
20 | Assembly and Testing | 30 days | Mon 6/11/12 | Fri 7/20/12 | 19,15,18
21
22 | Electronics | 80 days | Mon 3/19/12 | Fri 7/6/12
23 | Electronics Design | 20 days | Mon 3/19/12 | Fri 4/13/12
24 | Controller - Filter Wheels 20 days | | Mon 3/19/12 | Fri 4/13/12
25 | Controller - Guider Stages20 days | | Mon 3/19/12 | Fri 4/13/12
26 | Electronics Fabrication | 20 days | Mon 4/16/12 | Fri 5/11/12 | 23
27 | Electronics Assembly | 20 days | Mon 5/14/12 | Fri 6/8/12 | 26
28 | Electronics Testing | 20 days | Mon 6/11/12 | Fri 7/6/12 | 27
29
30 | Guider CCD | 60 days | Mon 3/19/12 | Fri 6/8/12
31 | Build Guide Cameras (2) | 30 days | Mon 3/19/12 | Fri 4/27/12
32 | Camera I/O Boards | 15 days | Mon 4/30/12 | Fri 5/18/12 | 31
33 | Build Camera Control Computers (3) 15 days | | Mon 5/21/12 | Fri 6/8/12 | 32
34
35 | Hardware Intergration | 25 days | Mon 7/23/12 | Fri 8/24/12
36 | Test and Assembly | 25 days | Mon 7/23/12 | Fri 8/24/12 | 3,14,22,30

38 | Software | 15 days | Mon 7/23/12 | Fri 8/10/12 | 3,14,22,30
39 | GUI Upgrade | 15 days | Mon 7/23/12 | Fri 8/10/12
40 | TCS - Software | 15 days | Mon 7/23/12 | Fri 8/10/12
41 | TCS - Hardware | 15 days | Mon 7/23/12 | Fri 8/10/12
42 | IMB/Guider - Telescope | 15 days | Mon 7/23/12 | Fri 8/10/12
43
44 | On-site Work (LCO) | 15 days | Mon 3/19/12 | Fri 4/6/12
45 | Install Guide Camera Cooling System 15 days | | Mon 3/19/12 | Fri 4/6/12
46
47 | PSR | 0 days | Fri 8/31/12 | Fri 8/31/12
48 | Ship to LCO | 0 days | Mon 9/10/12 | Mon 9/10/12
49 | Commissioning at LCO | 0 days | Mon 10/15/12 | Mon 10/15/12

Project: Swope Upgrade - 2012 03 21 Date: Fri 3/23/12 | Task Progress Summary External Tasks Deadline Split Milestone Project Summary External Milestone
