alanbagish/C40_upgrades/Documents/Galil/Galil_box Jan 25 3 pm - Dimensions.pdf

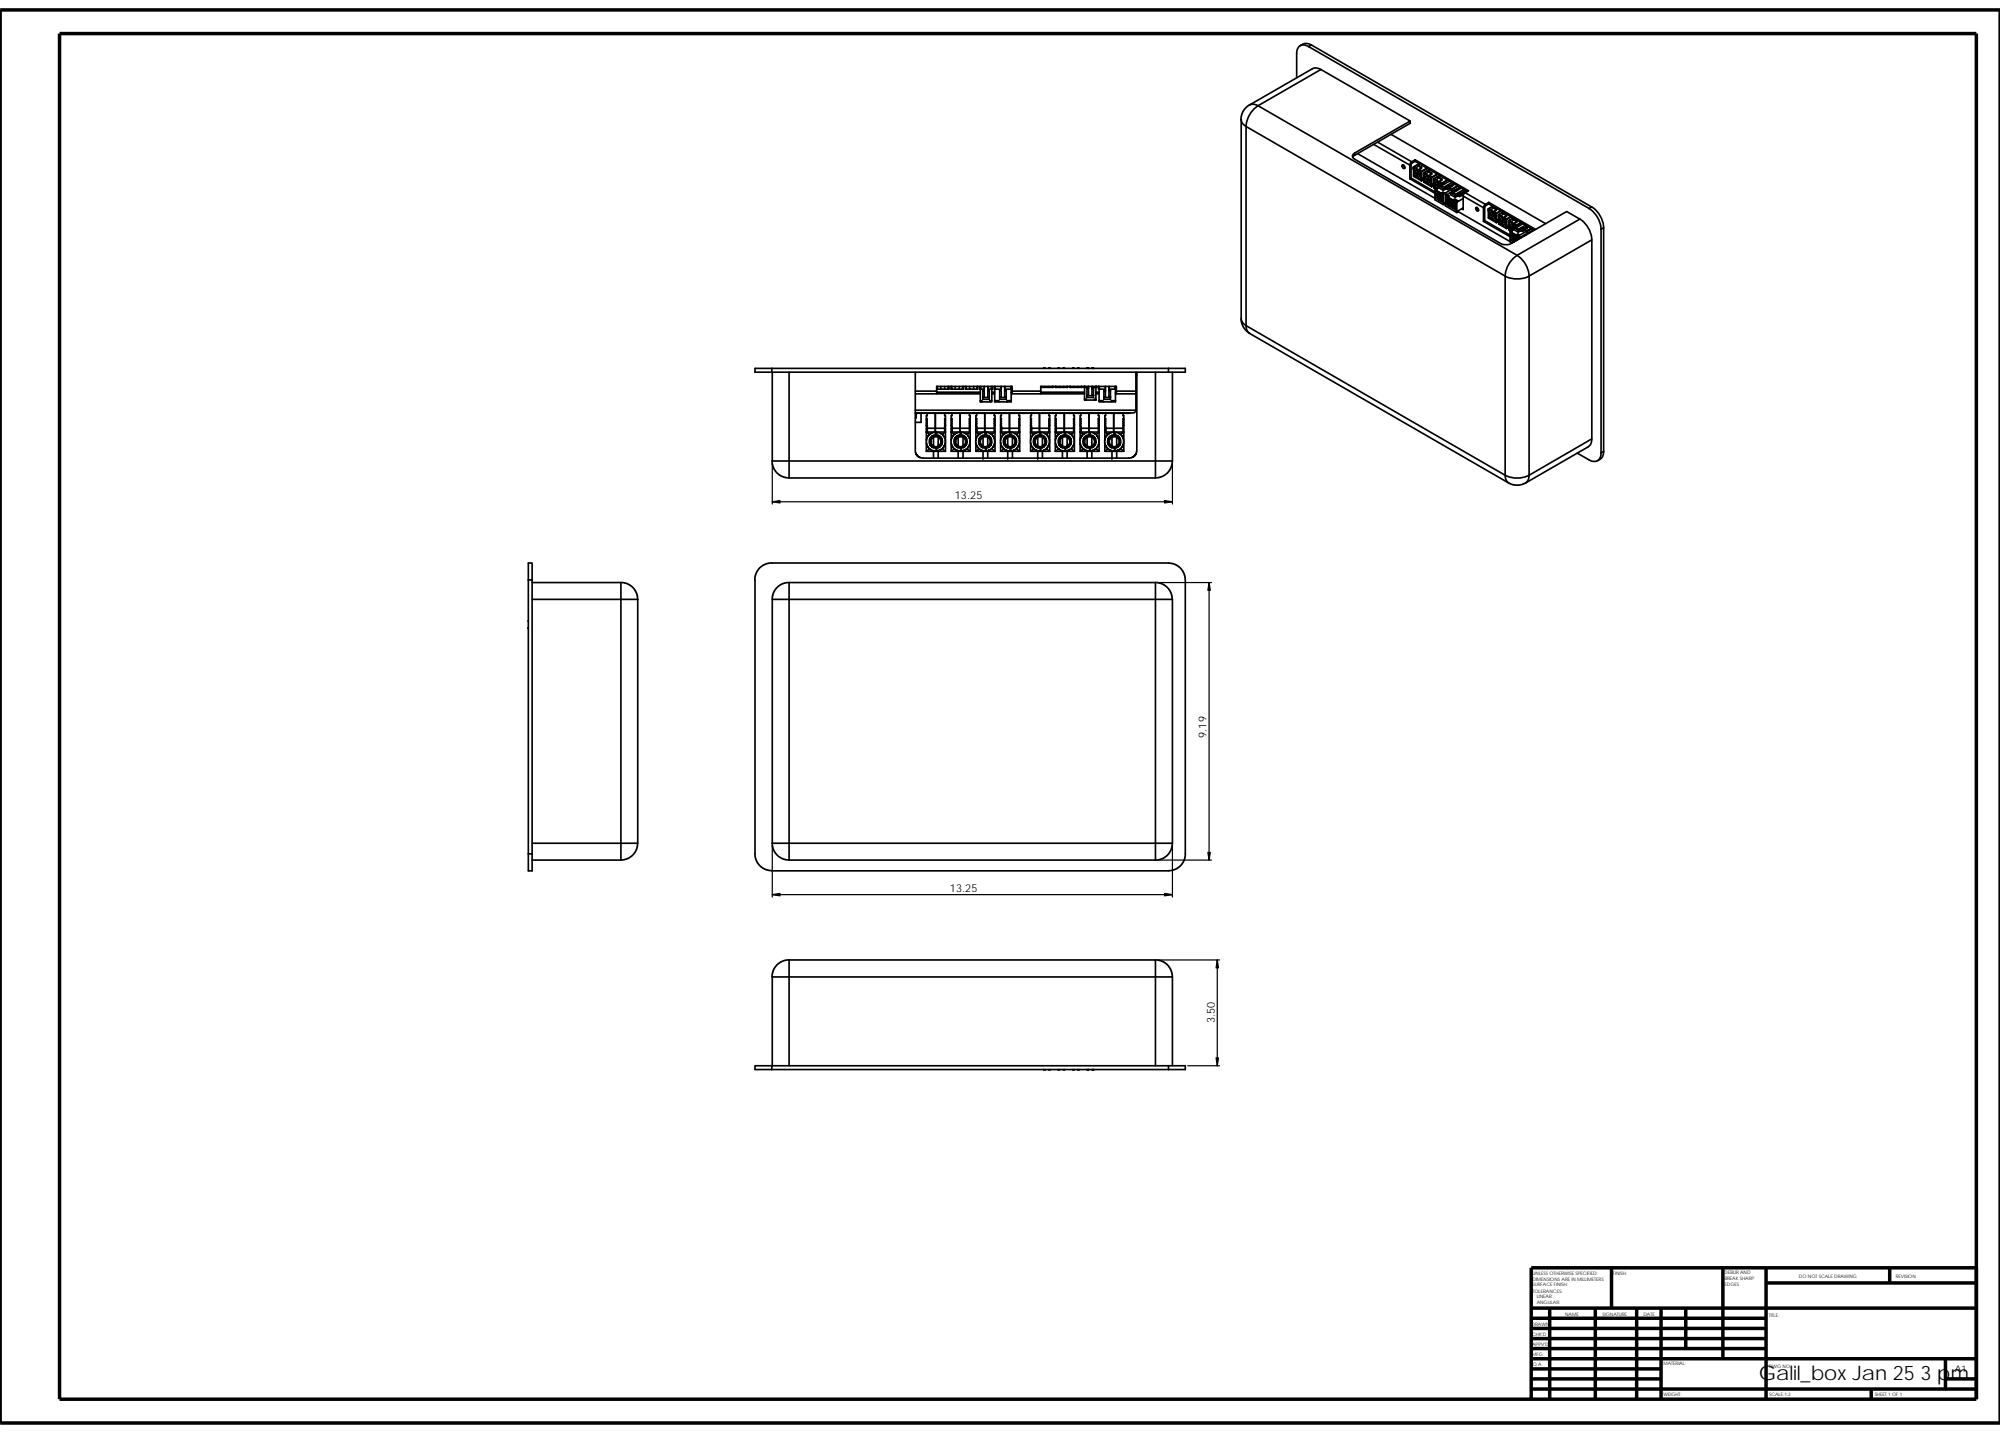
[picture p52: page 1]
FINISH:; DEBUR AND; EDGES; WEIGHT:; SCALE:1:2; SHEET 1 OF 1; DO NOT SCALE DRAWING; REVISION BREAK SHARP

UNLESS OTHERWISE SPECIFIED:
DIMENSIONS ARE IN MILLIMETERS
SURFACE FINISH:
TOLERANCES:
LINEAR:
ANGULAR:

DRAWN
CHK'D
APPV'D
MFG
Q.A | | | | MATERIAL: Galil_box Jan 25 3 pm | DWG NO. | A1

NAME | SIGNATURE | DATE | | | | TITLE:
