alanbagish/C40_upgrades/C40_Tyson_docs/Swope IMB Requirements Architecture.pdf

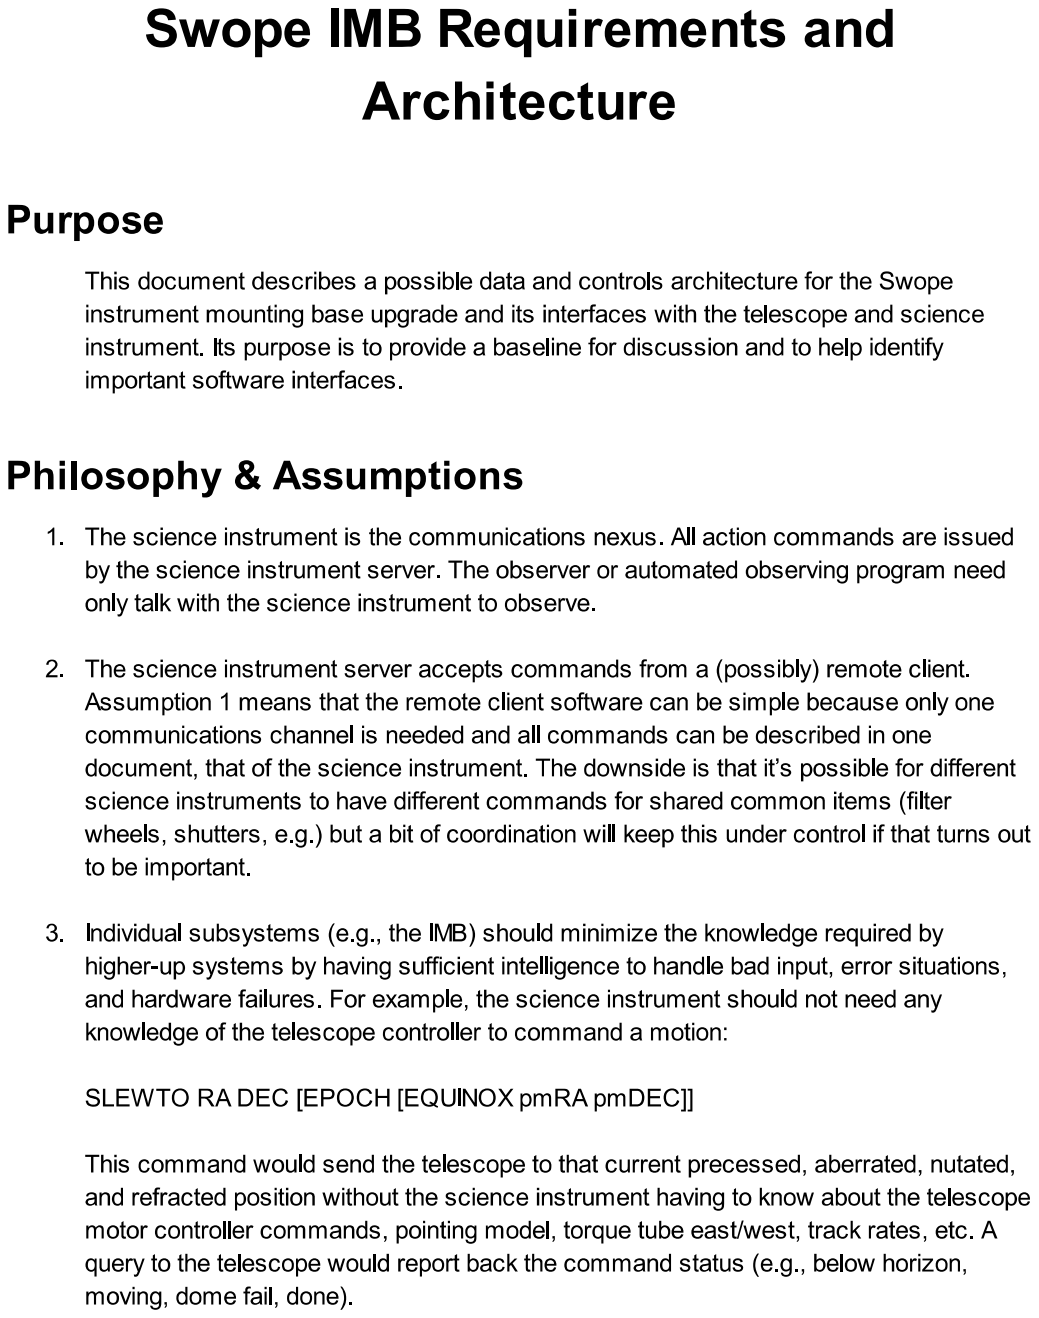
[picture p53: page 1]

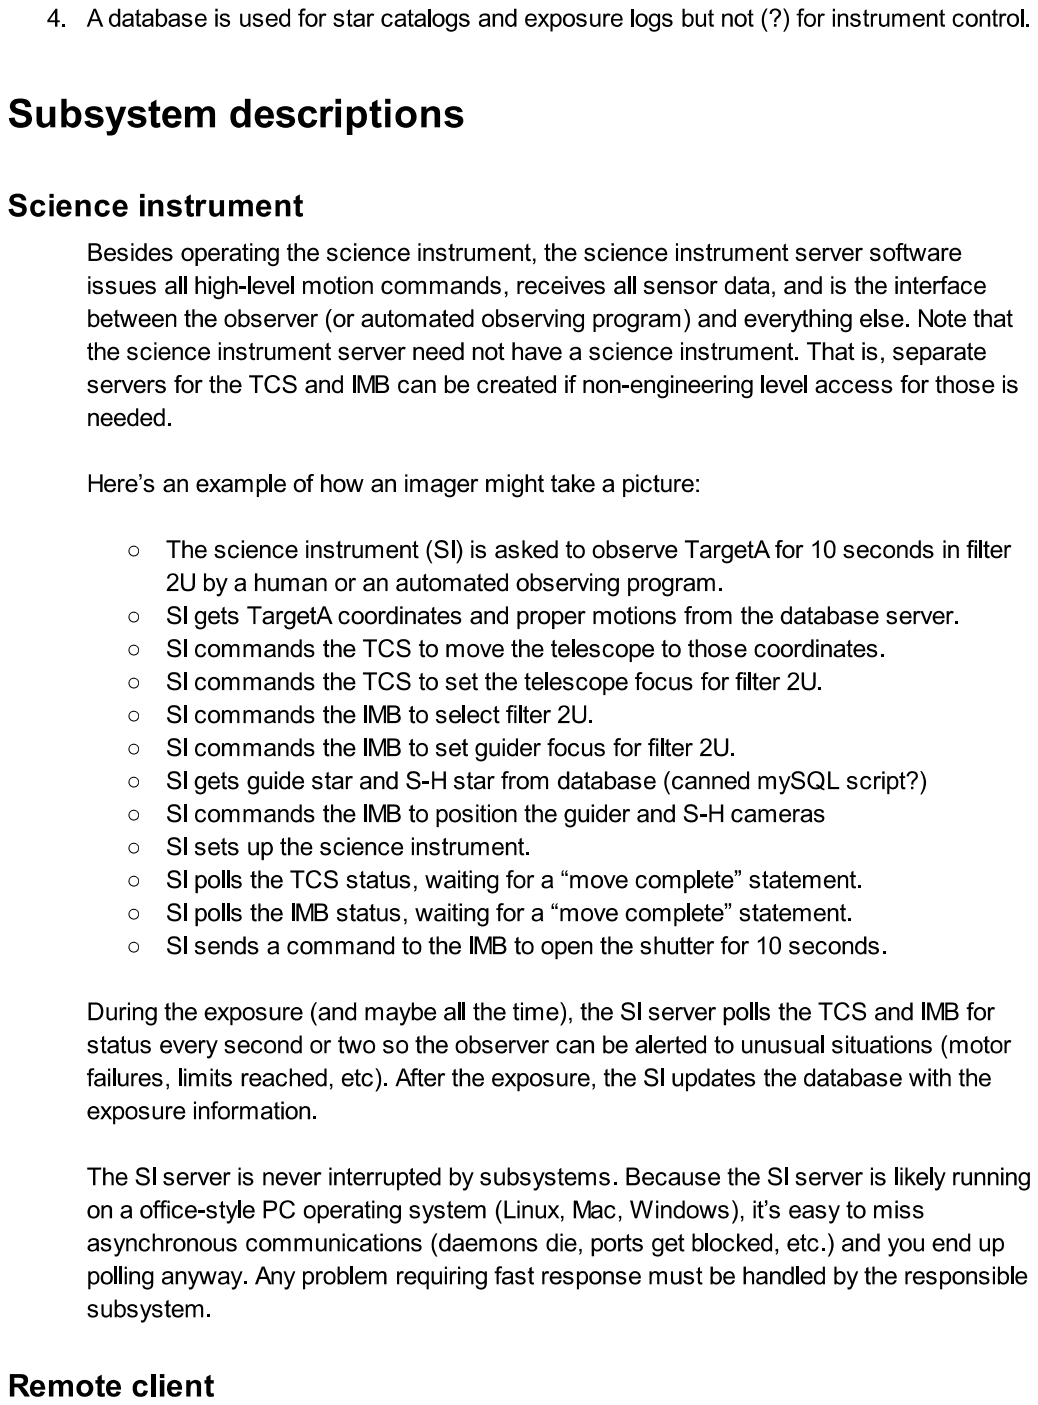
[picture p54: page 2]

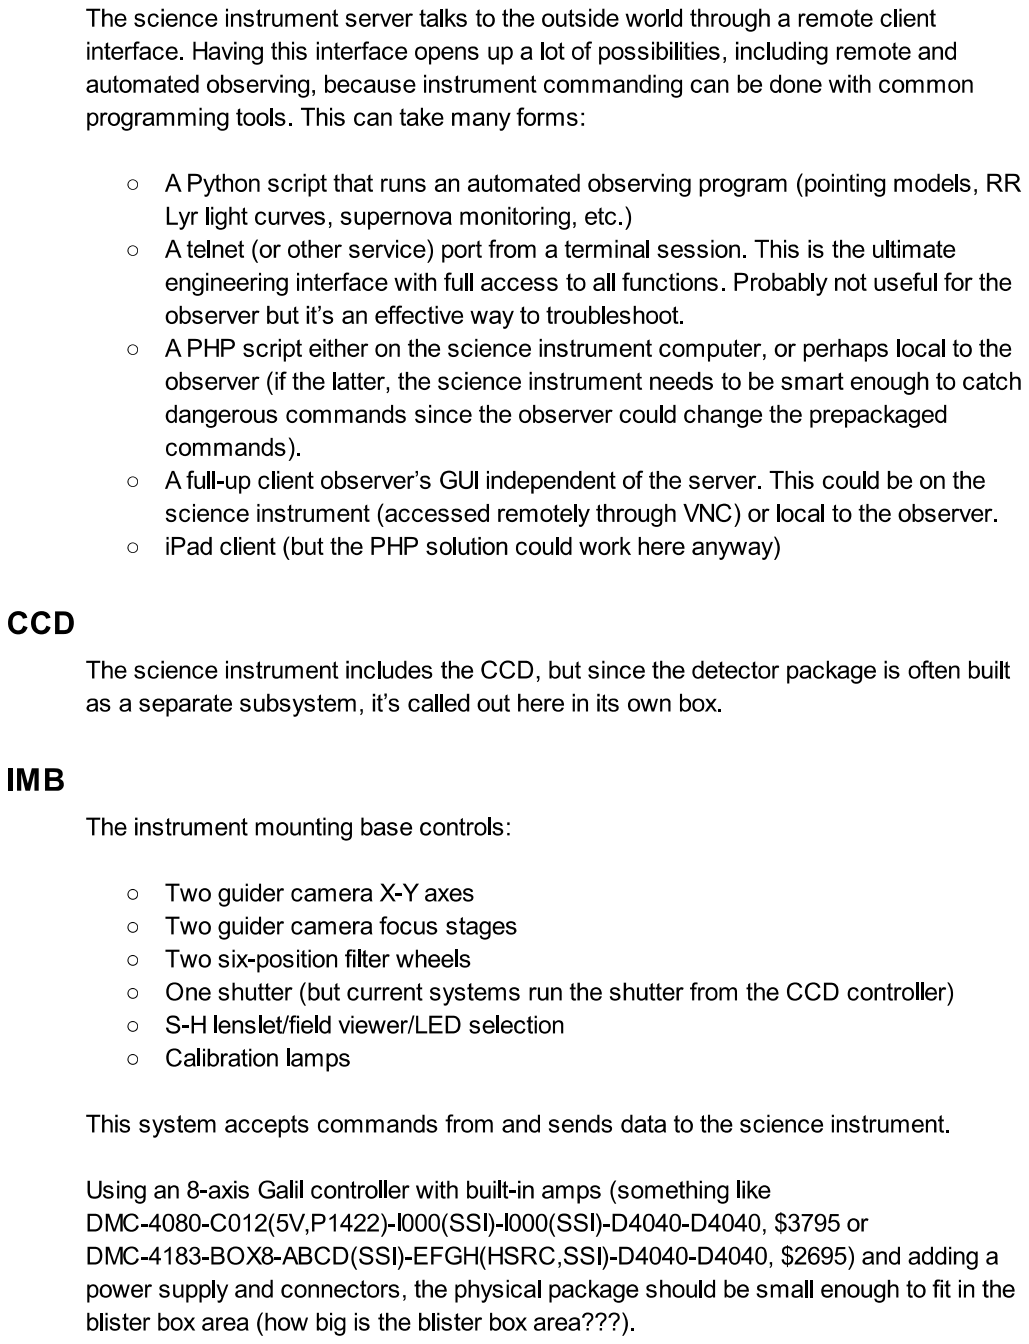
[picture p55: page 3]

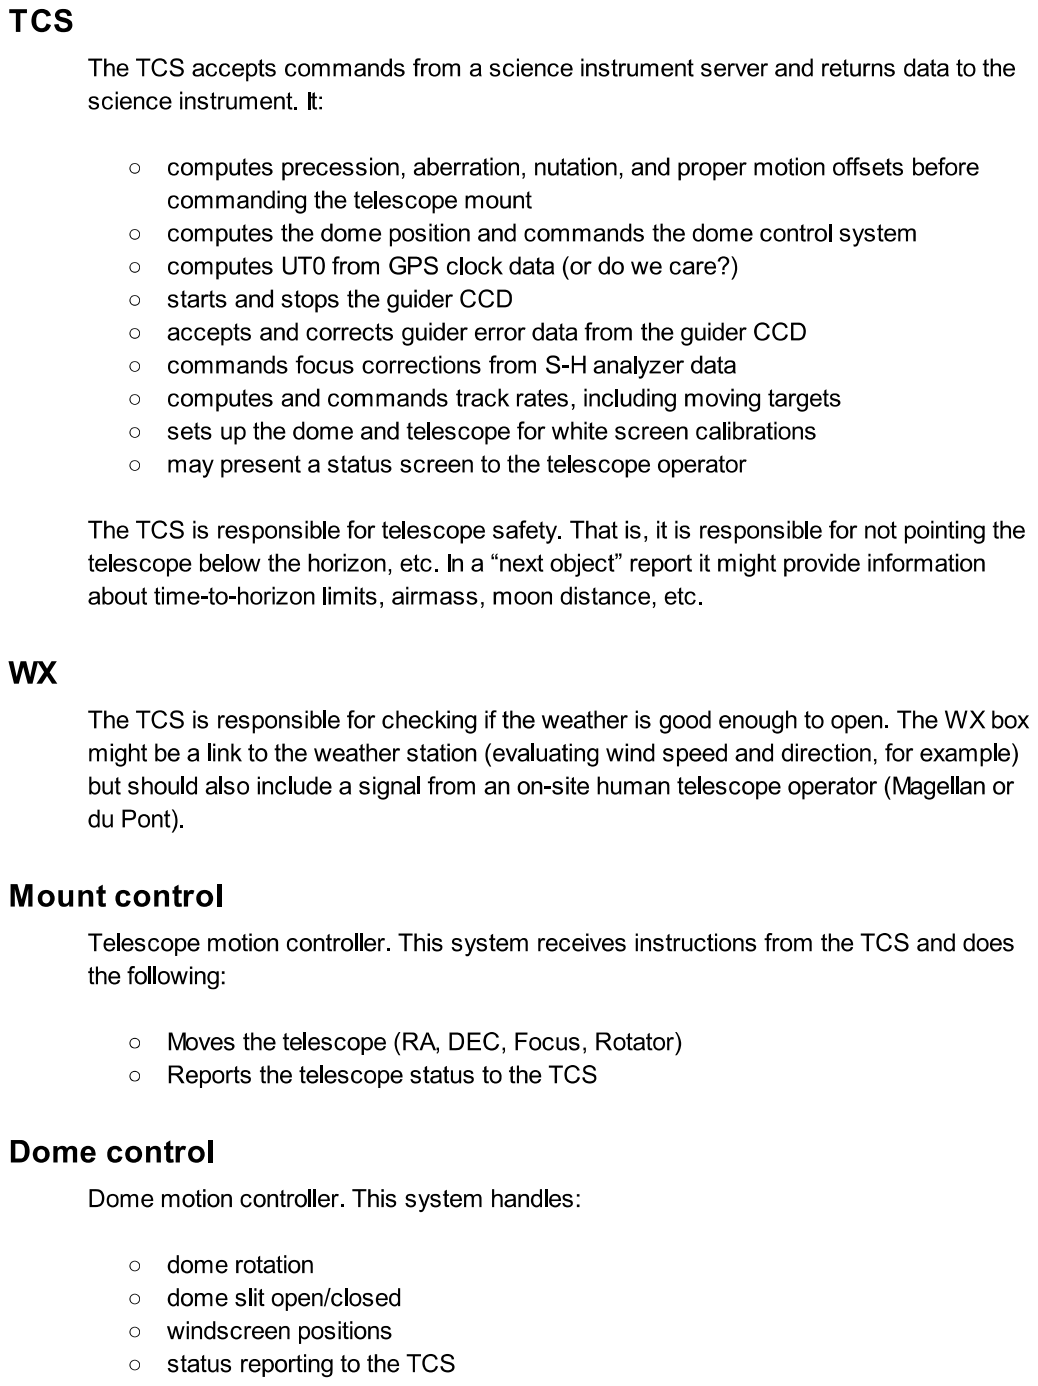
[picture p56: page 4]

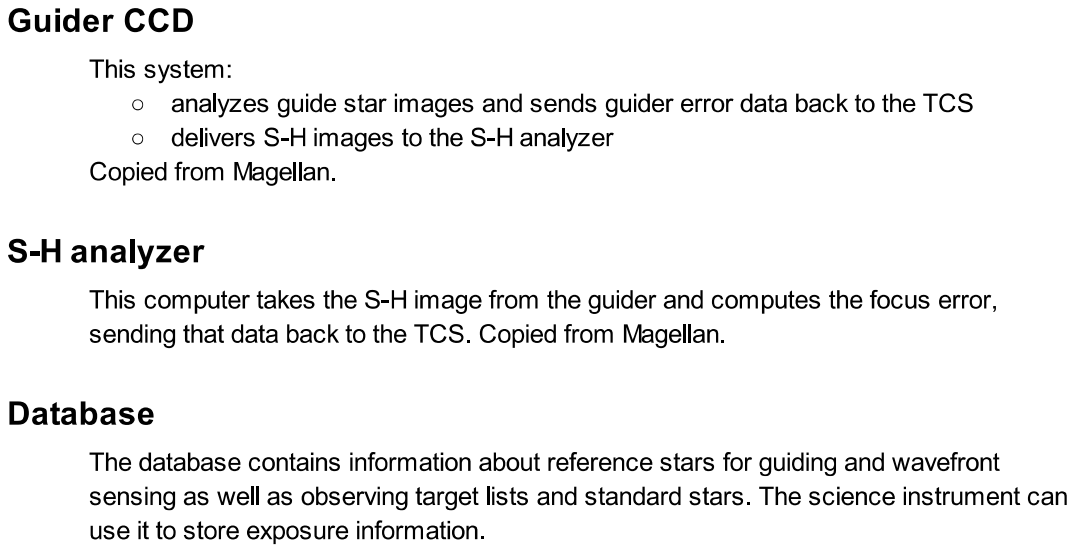
[picture p57: page 5]
