alanbagish/C40_upgrades/(list of files, drawings)

Other design files:
C40 IMB POWER SUPPLY.SchDoc
C40 IMB Upgrade.PrjPCB
C40 UPGRADES.PrjPCB
C40_IMB_Block_Diagram.SchDoc
C40_IMB_Block_Diagram_2.SchDoc
HARNESS.SchDoc
MOTORS ENCODERS.SchDoc
PROBE 1 CYLINDERS.SchDoc
PROBE 2 CYLINDERS.SchDoc
