alanbagish/C40_upgrades/(commit log)

2012-11-08 Block Diagram Overview added
    PP work, 2nd level diagram
    [C40 Power Supply Chassis.Sch, C40 Power Supply2 Chassis.Sch, C40 UPGRADES.PrjPCB, C40_IMB_Upgrade_OVERVIEW.SCHDOC, C40_IMB_Upgrade_block_diagram.SCHDOC, C40_IMB_Upgrade_block_diagram.~(3).SCHDOC, POWER SUPPLY.SchDoc]
2012-11-08 minor update
    [C40 UPGRADES.PrjPCB, C40_IMB_2nd level_block_diagram.SchDoc, C40_IMB_Upgrade_OVERVIEW.SCHDOC, C40_IMB_Upgrade_block_diagram.~(3).SCHDOC, C40_IMB_Upgrade_block_diagram2.Sch]
2012-11-09 major update
    of documentation package
    [C40 IMB POWER SUPPLY.SchDoc, C40 IMB Power Supply Chassis.Sch, C40 IMB Upgrade.PrjPCB, C40 Power Supply Chassis.Sch, C40_IMB_2nd level_block_diagram.SchDoc, C40_IMB_Block_Diagram.SchDoc, C40_IMB_Cover_Sheet.Sch, C40_IMB_Upgrade_OVERVIEW.SCHDOC]
2012-12-06 backup December 6 2012
    updated drawings
    [C40 IMB POWER SUPPLY.SchDoc, C40_IMB_2nd level_block_diagram.SchDoc, C40_IMB_Cover_Sheet.Sch, PROBE 1 CYLINDERS.SchDoc, PROBE 2 CYLINDERS.SchDoc]
2013-01-28 backup Jan 28th 2013
    [039012045 Molex 4 pin plug.SLDPRT, 039012045 Molex 4 pin plug.stp, 039310040 Molex 4 pin header.SLDPRT, 039310040 Molex 4 pin header.stp, 039310060 Molex 6 power header.SLDPRT, 039310060 Molex 6 power header.stp, 050361672 Molex 6 plug.SLDPRT, 050361672 Molex 6 plug.stp]
2013-01-31 backup Jan 31st
    [01234011 released Rose box.SLDASM, 1.sldprt, 2.sldprt, 3.sldprt, 4.sldprt, C40_IMB_Block_Diagram_2.SchDoc, DMC4080_A_model-42200-1.sldasm, DMC4080_A_model-42200-1.sldprt]
2013-02-05 backup Feb 5 2013
    [C40_IMB_Block_Diagram_2.SchDoc]
2013-02-22 backup Feb 22 2013
    [050579408.SLDPRT, 050579408.stp, 701070007 housing.SLDPRT, 701070007.stp, Assem1.SLDASM, C40 IMB Power Supply Chassis.Sch, C40 IMB Upgrade.PrjPCB, C40 Power Supply selection.xlsx]
2013-03-18 backup March 18 2013
    [C40 IMB Upgrade.PrjPCB, C40_IMB_Block_Diagram_2.SchDoc]
2013-03-25 backup March 25 2013
    [C40 IMB POWER SUPPLY.SchDoc, MOTORS ENCODERS.SchDoc]
